Ttl/vna/README.md

Homemade 30 MHZ - 6 GHz single receiver VNA design files.
