Ttl/vna/(threads)

Thread 1 (2018-06-11):

Questions about the simu sw, and calibrations

shinong, 2018-06-11:
Hi,
First of all, thank you so much for sharing the design of your self-designed VNA. I did learn a lot from your docs. And it helped me a lot on my thesis research. However, I do have some questions about your documents in this project.
First, what is the simulation software you used in your design stage, and how you generated your PCB layout? Did you calculate the width of the trace and use this parameter for manual routing or you used the simu software to generate the layout directly?
Second, for the calibration method. You used the 3-term error model for 1 port cali, and you used magnitudes only for calibration. I am not clear about how phase data is used for calibration? Cause you mentioned in another project that VNA is more accurate than SNA because of the phase correction.
Those are all questions I have for now. Could you please take some time to look at them and reply me whenever you are convenient? Really appreciated!

Thanks,
Shinong

Ttl, 2018-06-12:
There isn't that much to simulate. Most is done just with pen and paper. Couplers were simulated using EM simulator. Line width was calculated to give 50 ohm impedance and the layout was done manually in KiCad.

Phases are needed because in general linear two ports have phases and we need to solve the coefficients of the error network during the calibration.

Closed 2018-06-12.

Thread 2 (2018-06-17):

LICENSE?

Immortalin, 2018-06-17:
Which license is this under?

Ttl, 2018-06-18:
Firmware is GPL (See firmware/COPYING for license). I guess I never put any license for software. Do you want it to have some specific license?

Immortalin, 2018-06-18:
I mean is the EE considered to be Open Hardware?

Ttl, 2018-06-18:
Sure. Do what you want with it. Hardware can't be copyrighted anyways.

UsedUp, 2019-06-29:
Has anybody compiled a BOM for the improved version of the vna?  I saw a mention of somebody in the process of doing it but I have seen no final list though I have noticed a list changes for the components which I cannot read (understand).  I can make a tiny amount of sense like maybe the kind of part but value and SMD size are beyond my grasp of the system.  Maybe all I need is to know which software reads the file  (is that all in Kicad, which I glanced at but have not tried downloading? ) (I have been using Target)?  To be honest, I have never tried building anything of this sort and recently have been doing circuits using maybe 50 parts and doing the bookkeeping myself.  Conversely. I have an immediate job where the VNA could greatly help.
    If just setting up Kicad is enough then I am ready to go that route even if it takes some learning of a different program.  I just read a comparison to Eagle and the author left me feeling they are comparable. Maybe I will actually be happier doing so. Target has some habits I could do without when placing components very near each other.
