Ttl/vna/hardware/vna_sch.pdf

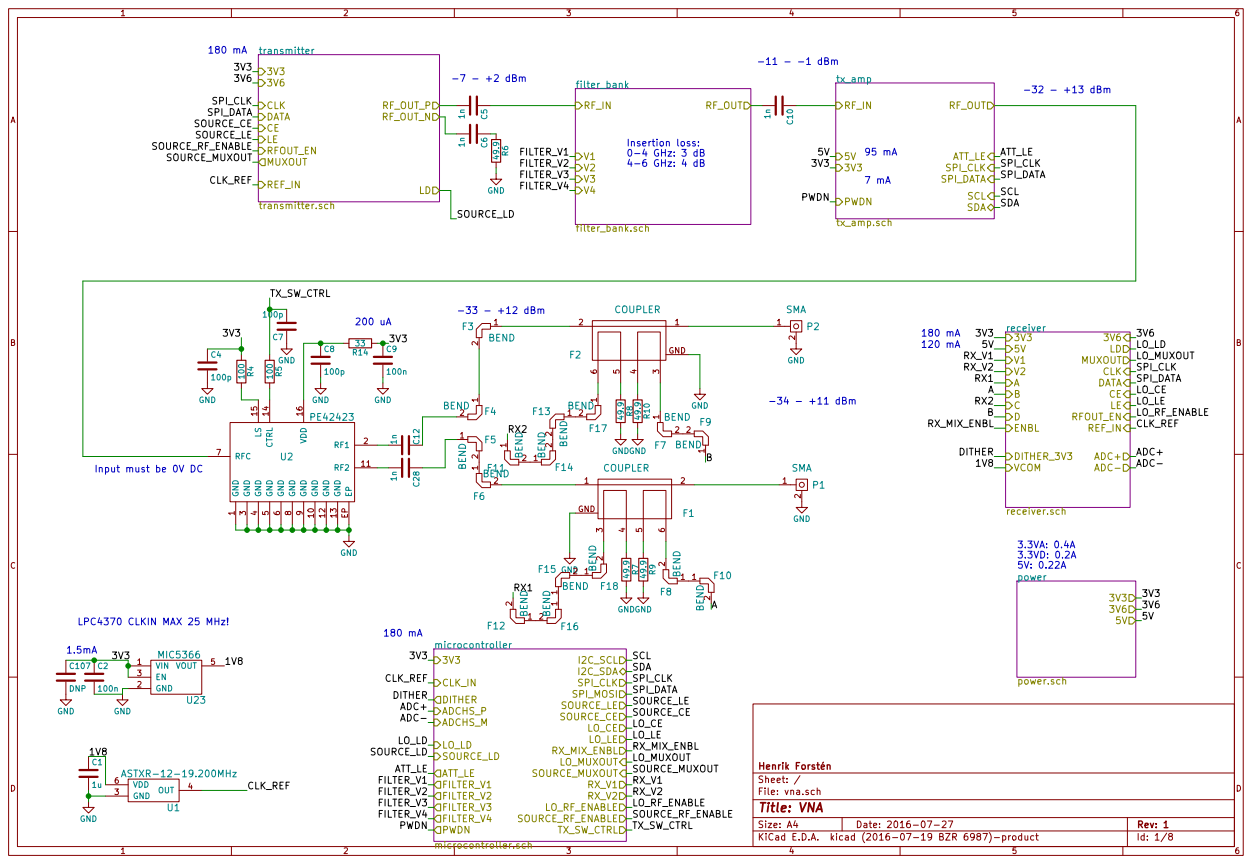
[picture p1: page 1]

Insertion loss: 0-4 GHz: 3 dB
4-6 GHz: 4 dB

9 GND 10 RF2 11 GND 12 GND 13 CTRL 14 LS 15 VDD 16 EP EP U2 PE42423

Input must be 0V DC

File: vna.sch Sheet: / Henrik Forstén

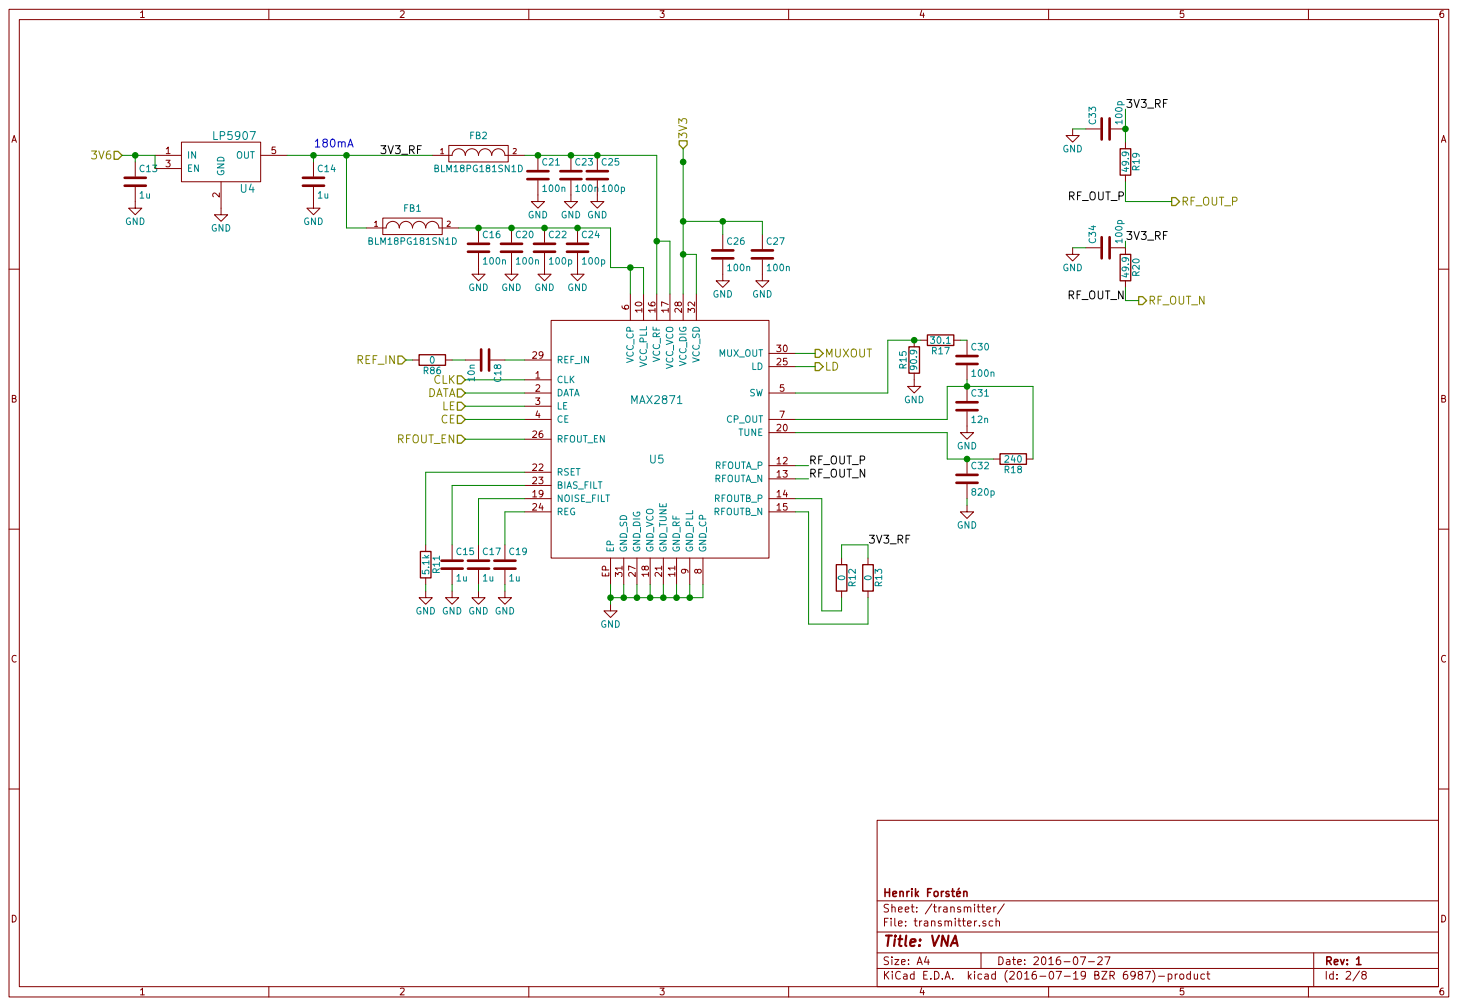
[picture p2: page 2]

100n GND GND GND GND GND

100n 5.1k R11 GND GND GND GND

File: transmitter.sch Sheet: /transmitter/ Henrik Forstén

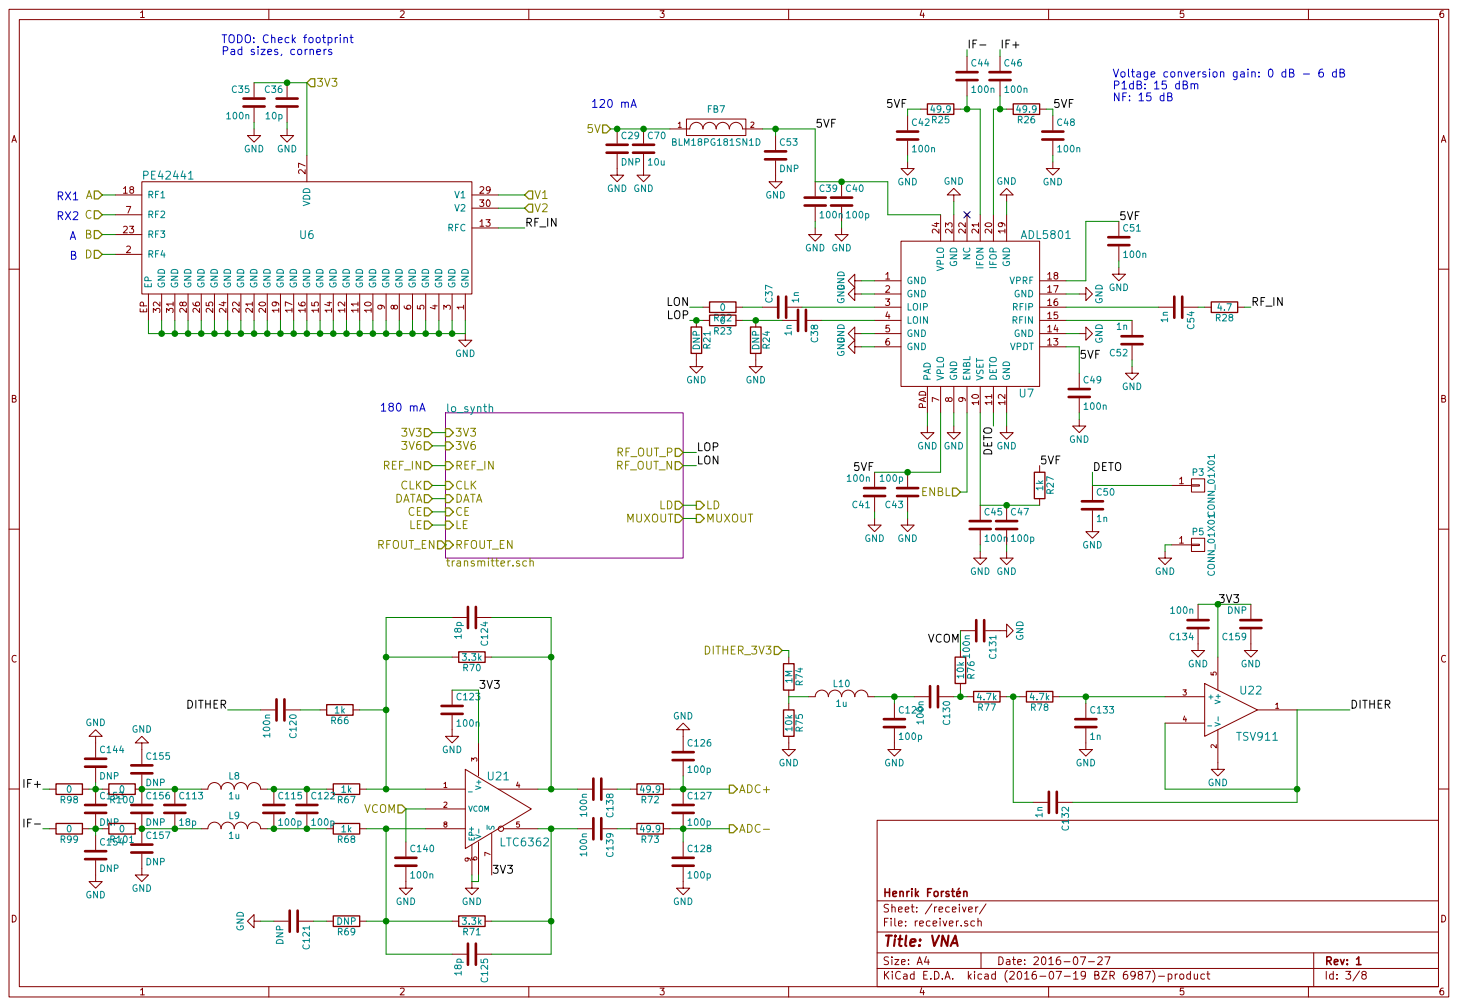
[picture p3: page 3]

9 GND 10 GND 20 V2 30 GND 11 GND 21 GND 31 GND 12 GND 22 GND 32 RFC 13 RF3 23 GND 14 GND 24 GND 15 GND 25 GND 16 GND 26 GND 17 VDD 27 RF1 18 GND 28 GND 19 V1 29 EP EP U6 PE42441

9 VSET 10 IFOP 20 DETO 11 IFON 21 GND 12 NC 22 VPDT 13 GND 23 GND 14 VPLO 24 RFIN 15 RFIP 16 GND 17 VPRF 18 GND 19 PAD PADU7ADL5801 RF_IN GND GND C37 1n

File: receiver.sch Sheet: /receiver/ Henrik Forstén GND

C155 DNP C157 DNP GND GND

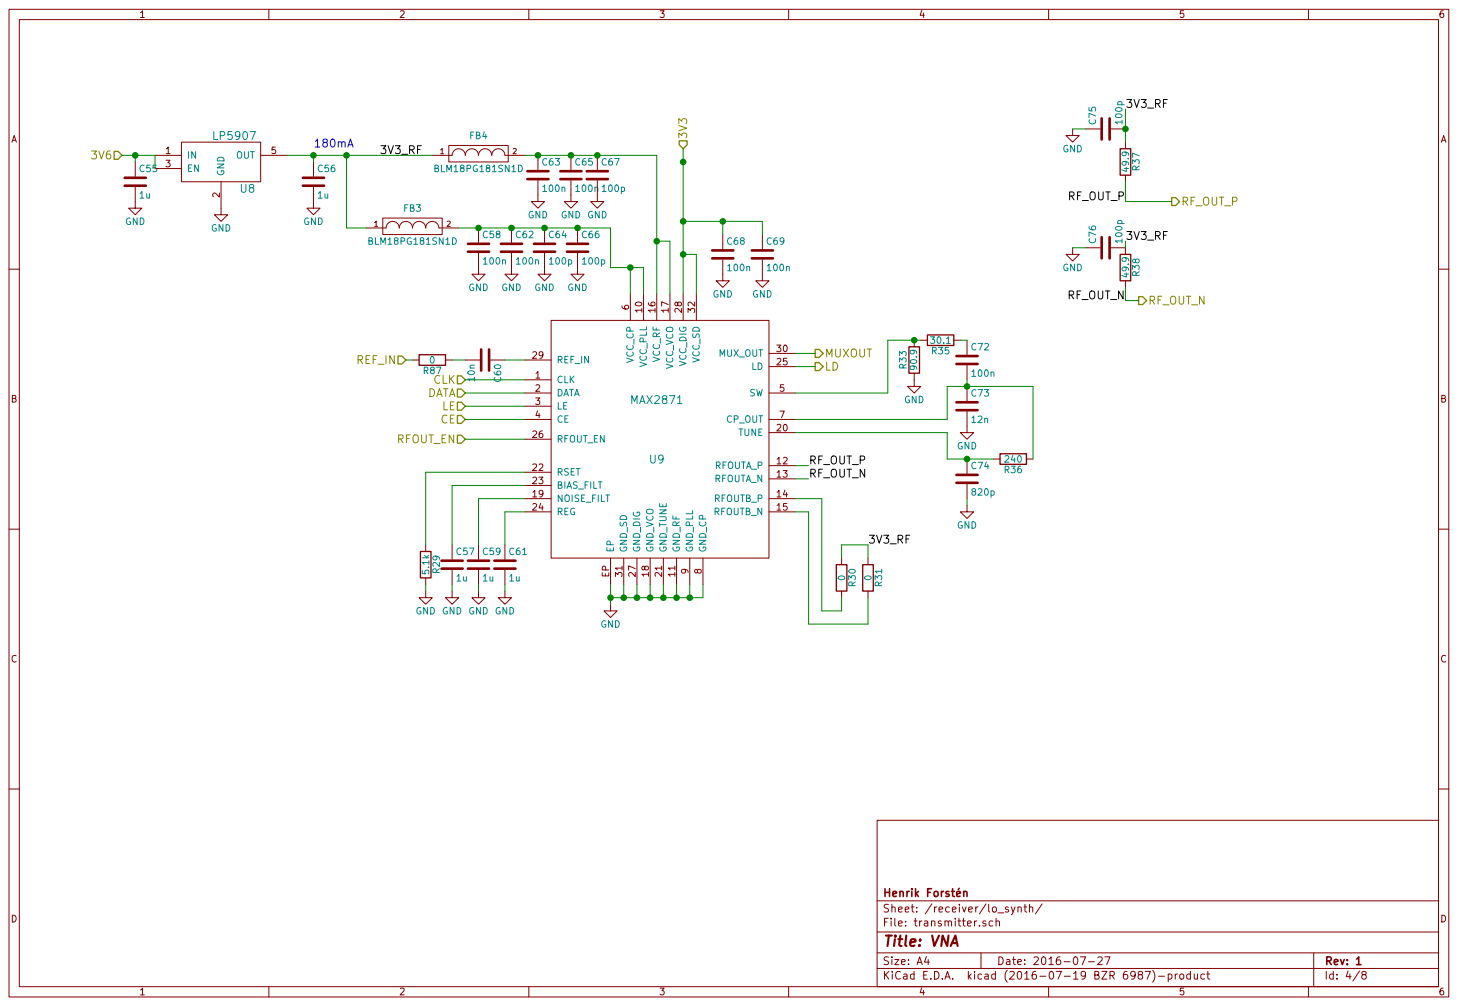
[picture p4: page 4]

100n GND GND GND GND GND

100n 5.1k R29 GND GND GND GND

Henrik Forstén
File: transmitter.sch Sheet: /receiver/lo_synth/
Id: 4/8 Title: VNA

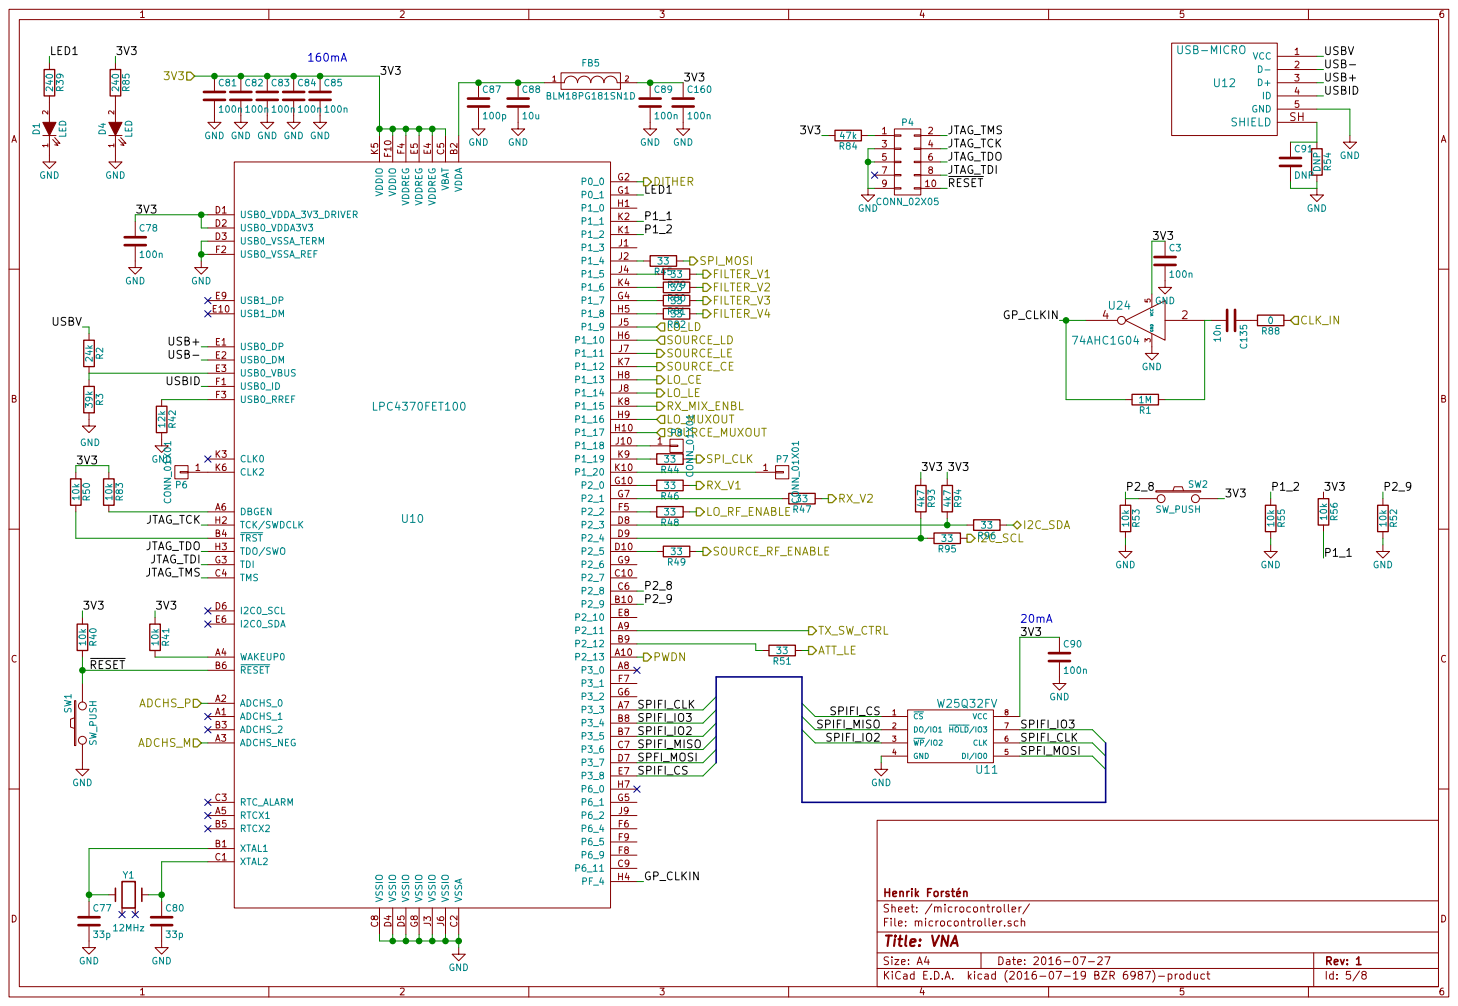
[picture p5: page 5]

LPC4370FET100 GND GND GND GND GND

SPIFI_IO2
SPIFI_MISO
SPFI_MOSI

File: microcontroller.sch Sheet: /microcontroller/ Henrik Forstén

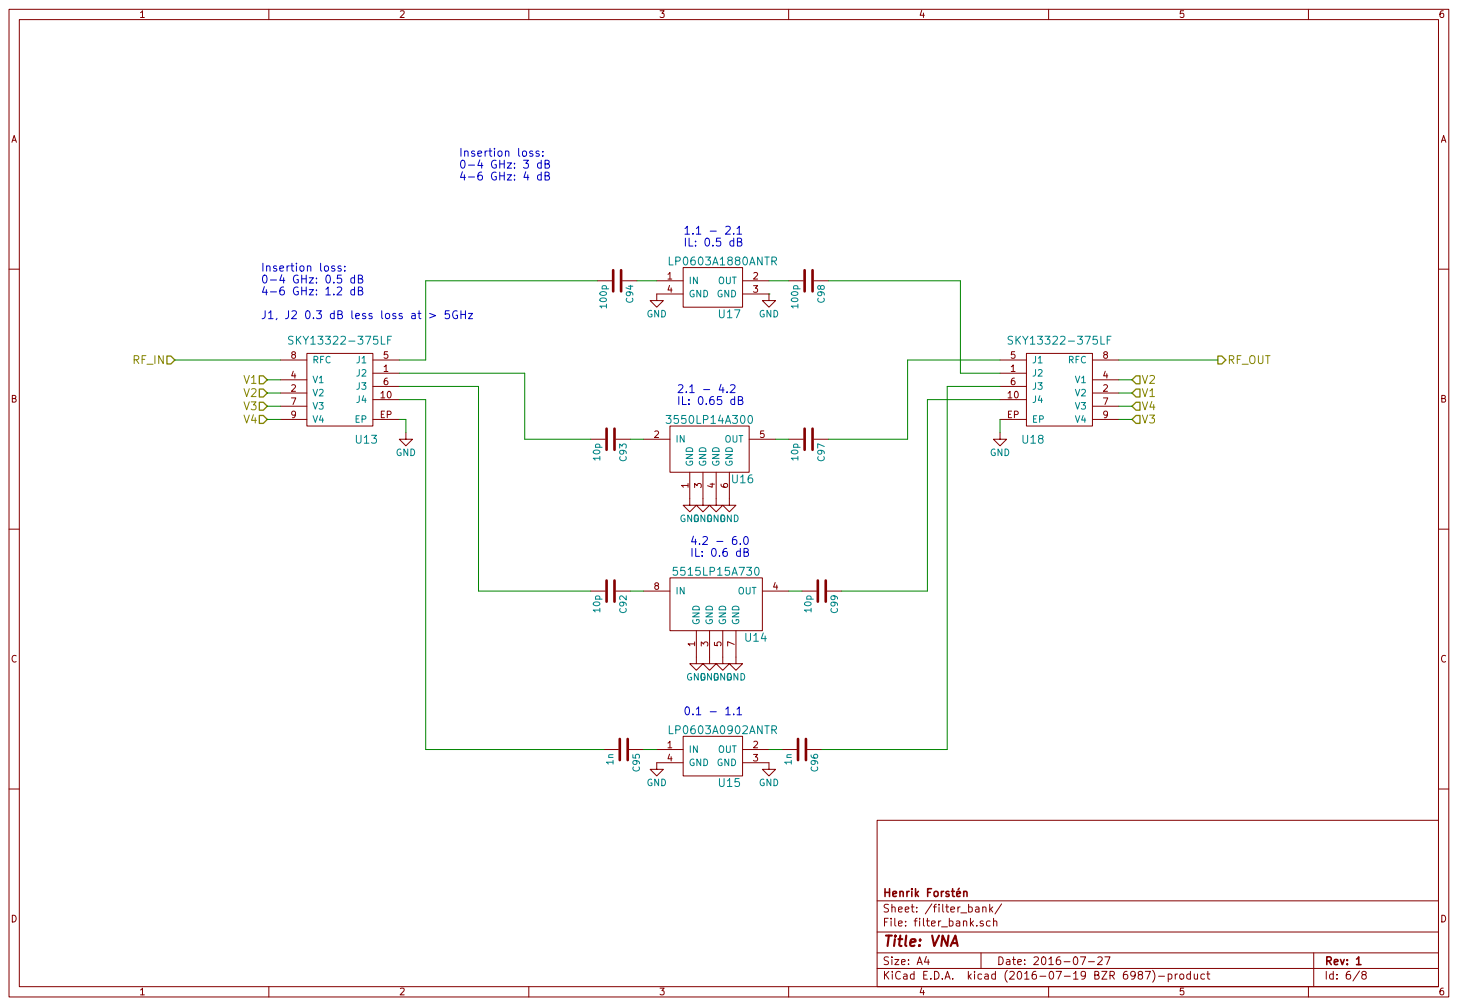
[picture p6: page 6]

Insertion loss: 0-4 GHz: 3 dB
4-6 GHz: 4 dB

Insertion loss: 0-4 GHz: 0.5 dB
4-6 GHz: 1.2 dB
J1, J2 0.3 dB less loss at > 5GHz

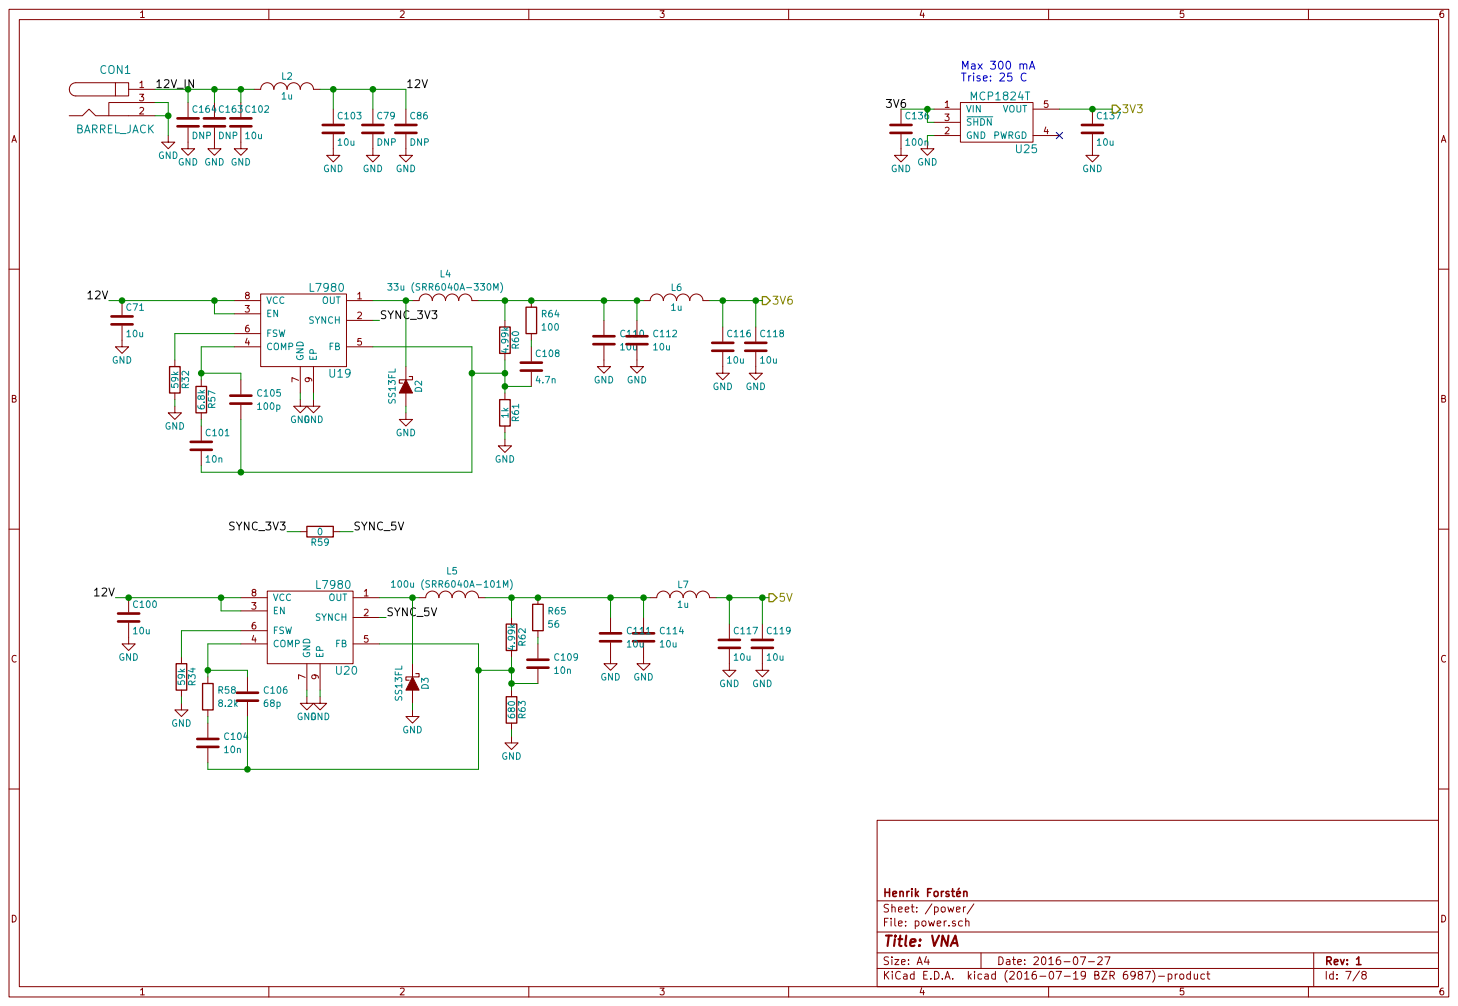
[picture p7: page 7]

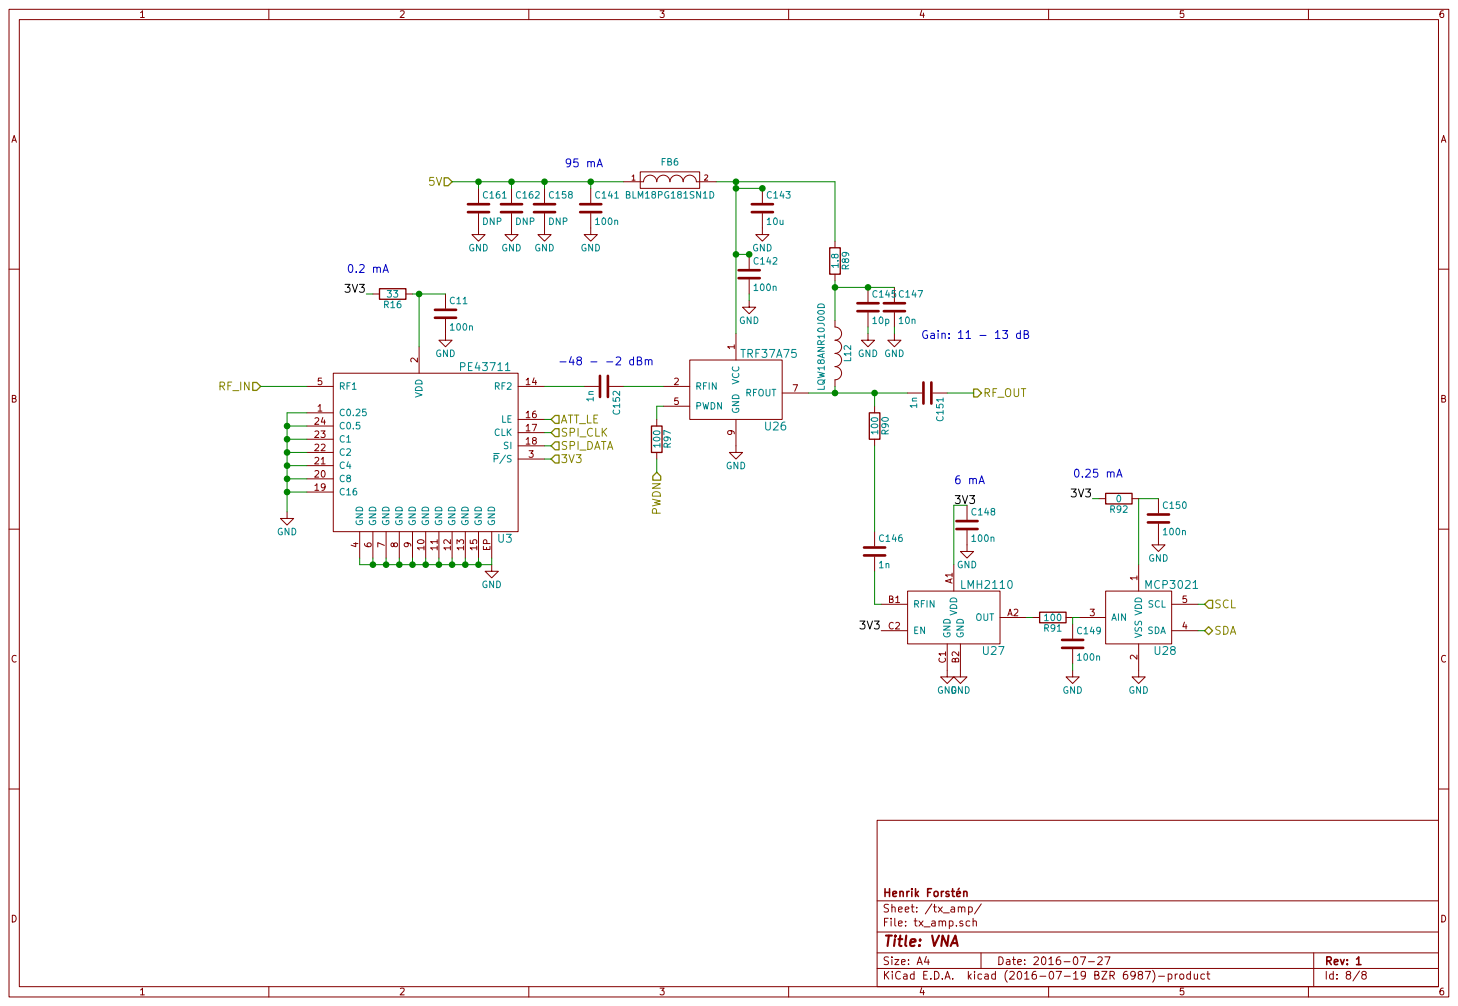
[picture p8: page 8]

1 RFIN 2 PWDN 5 RFOUT 7 GND

9 GND 10 C8 20 GND 11 C4 21 GND 12 C2 22 GND 13 C1 23 RF2 14 C0.5 24 GND 15
