Ttl/vna/hardware/vna.kicad_pcb

## KiCad design hardware/vna.kicad_pcb (2016-07-27)

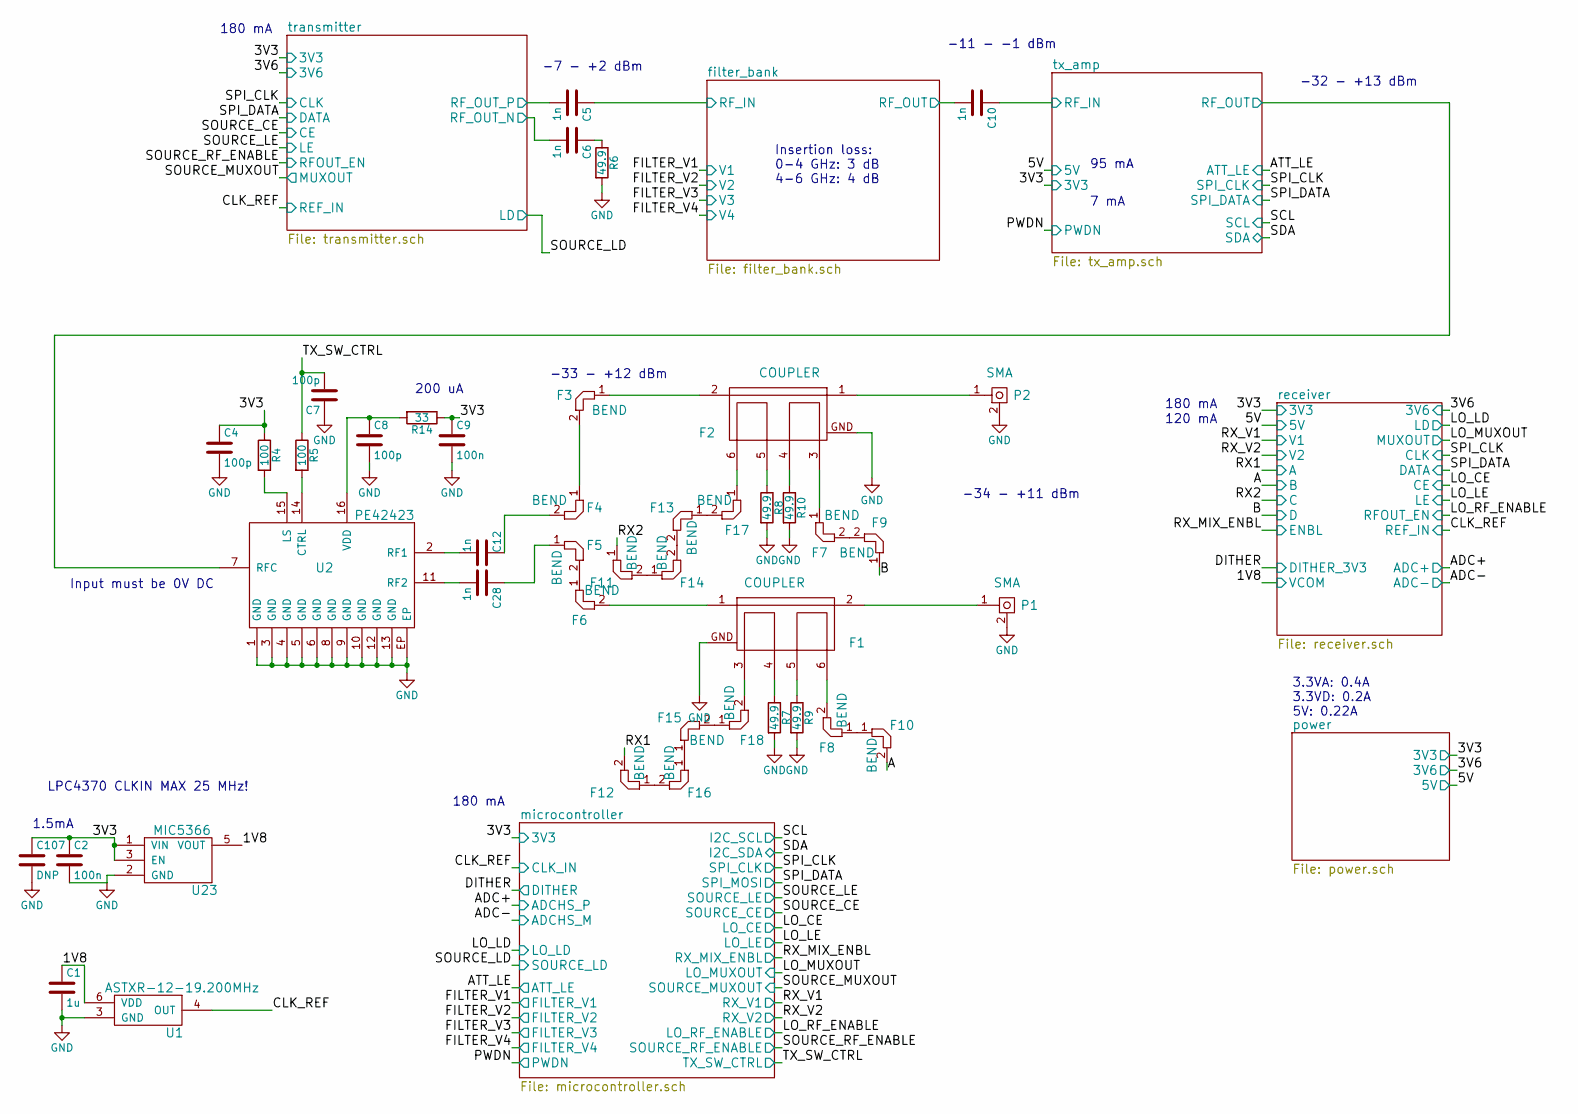
[picture p9: schematic vna.sch]

Parts:
C1: 1u; C_0402b
C2, C9: 100n; C_0402b
C4, C7, C8: 100p; C_0402b
C5, C6, C10, C12, C28: 1n; C_0402b
C107: DNP; C_0805b
F1, F2: COUPLER; coupler4
F3, F4, F5, F6, F7, F8, F9, F10, F11, F12, F13, F14, F15, F16, F17, F18: BEND; uwmiter_0.34_0.17_45
P1, P2: SMA; CONSMA003.062
R4, R5: 100; R_0402b
R6, R7, R8, R9, R10: 49.9; R_0402b
R14: 33; R_0402b
U1: ASTXR-12-19.200MHz; ASTRX-12
U2: PE42423; VQFN-16
U23: MIC5366; SOT-353

Connections:
/filter_bank/RF_IN: C5.1; also elsewhere on the board
/filter_bank/RF_OUT: C10.2; also elsewhere on the board
/microcontroller/3V3: C2.1, C4.1, C9.1, C107.1, R4.1, R14.1, U23.1 (VIN), U23.3 (EN); also elsewhere on the board
/microcontroller/CLK_IN: U1.4 (OUT); also elsewhere on the board
/microcontroller/TX_SW_CTRL: C7.2, R5.1; also elsewhere on the board
/receiver/A: F12.2; also elsewhere on the board
/receiver/B: F10.2; also elsewhere on the board
/receiver/C: F11.1; also elsewhere on the board
/receiver/D: F9.1; also elsewhere on the board
/receiver/VCOM: C1.1, U1.6 (VDD), U23.5 (VOUT); also elsewhere on the board
/transmitter/RF_OUT_N: C6.2; also elsewhere on the board
/transmitter/RF_OUT_P: C5.2; also elsewhere on the board
/tx_amp/RF_IN: C10.1; also elsewhere on the board
/tx_amp/RF_OUT: U2.7 (RFC); also elsewhere on the board
GND: C1.2, C2.2, C4.2, C7.1, C8.2, C9.2, C107.2, F1.GND, F2.GND, P1.2, P2.2, R6.2, R7.2, R8.2, R9.2, R10.2, U1.3 (GND), U2.1 (GND), U2.3 (GND), U2.4 (GND), U2.5 (GND), U2.6 (GND), U2.8 (GND), U2.9 (GND), U2.10 (GND), U2.12 (GND), U2.13 (GND), U2.EP, U23.2 (GND); also elsewhere on the board
unnamed: C6.1, R6.1
unnamed: C8.1, R14.2, U2.16 (VDD)
unnamed: C12.1, F4.2
unnamed: C12.2, U2.2 (RF1)
unnamed: C28.1, F5.1
unnamed: C28.2, U2.11 (RF2)
unnamed: F1.1, F6.2
unnamed: F1.2, P1.1
unnamed: F1.3, F18.2
unnamed: F1.4, R7.1
unnamed: F1.5, R9.1
unnamed: F1.6, F8.2
unnamed: F2.1, P2.1
unnamed: F2.2, F3.1
unnamed: F2.3, F7.1
unnamed: F2.4, R10.1
unnamed: F2.5, R8.1
unnamed: F3.2, F4.1
unnamed: F5.2, F6.1
unnamed: F7.2, F9.2
unnamed: F8.1, F10.1
unnamed: F11.2, F14.1
unnamed: F12.1, F16.2
unnamed: F13.1, F17.2
unnamed: F13.2, F14.2
unnamed: F15.1, F16.1
unnamed: F15.2, F18.1
unnamed: F2.6, F17.1
unnamed: R4.2, U2.15 (LS)
unnamed: R5.2, U2.14 (CTRL)

Notes on the sheet:
1.5mA
Input must be 0V DC
Insertion loss: 0-4 GHz: 3 dB 4-6 GHz: 4 dB
-7 - +2 dBm
-11 - -1 dBm
-32 - +13 dBm
-33 - +12 dBm
-34 - +11 dBm
200 uA
180 mA
120 mA
3.3VA: 0.4A 3.3VD: 0.2A 5V: 0.22A
LPC4370 CLKIN MAX 25 MHz!
95 mA
7 mA

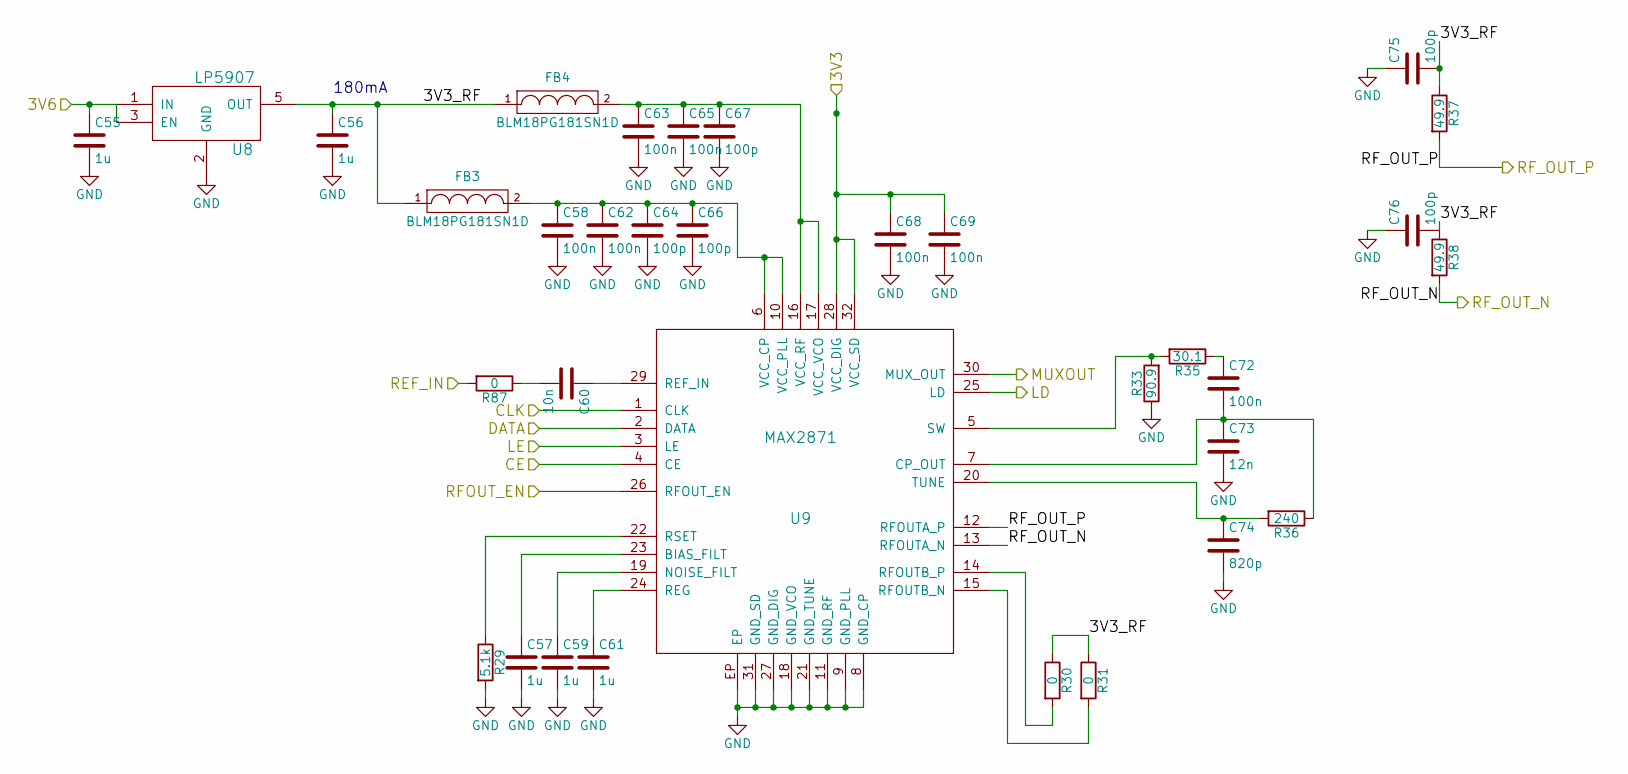
[picture p10: schematic transmitter.sch, VNA]

Parts:
C13, C14, C15, C17, C19: 1u; C_0603b
C16, C20, C21, C23, C26, C27, C30: 100n; C_0402b
C18: 10n; C_0402b
C22, C24, C25, C33, C34: 100p; C_0402b
C31: 12n; C_0402b
C32: 820p; C_0402b
FB1, FB2: BLM18PG181SN1D; C_0603b
R11: 5.1k; R_0402b
R12, R13, R86: 0; R_0402b
R15: 90.9; R_0402b
R17: 30.1; R_0402b
R18: 240; R_0402b
R19, R20: 49.9; R_0402b
U4: LP5907; SOT-23-5
U5: MAX2871; TQFN-32

Connections:
/microcontroller/3V3: C26.1, C27.1, U5.28 (VCC_DIG), U5.32 (VCC_SD); also elsewhere on the board
/microcontroller/CLK_IN: R86.2; also elsewhere on the board
/power/3V6: C13.1, U4.1 (IN), U4.3 (EN); also elsewhere on the board
/receiver/CLK: U5.1 (CLK); also elsewhere on the board
/receiver/DATA: U5.2 (DATA); also elsewhere on the board
/transmitter/3V3_RF: C14.1, C33.2, C34.2, FB1.1, FB2.1, R12.1, R13.1, R19.1, R20.1, U4.5 (OUT)
/transmitter/CE: U5.4 (CE); also elsewhere on the board
/transmitter/LD: U5.25 (LD); also elsewhere on the board
/transmitter/LE: U5.3 (LE); also elsewhere on the board
/transmitter/MUXOUT: U5.30 (MUX_OUT); also elsewhere on the board
/transmitter/RFOUT_EN: U5.26 (RFOUT_EN); also elsewhere on the board
/transmitter/RF_OUT_N: R20.2, U5.13 (RFOUTA_N); also elsewhere on the board
/transmitter/RF_OUT_P: R19.2, U5.12 (RFOUTA_P); also elsewhere on the board
GND: C13.2, C14.2, C15.2, C16.2, C17.2, C19.2, C20.2, C21.2, C22.2, C23.2, C24.2, C25.2, C26.2, C27.2, C31.2, C32.2, C33.1, C34.1, R11.2, R15.1, U4.2 (GND), U5.8 (GND_CP), U5.9 (GND_PLL), U5.11 (GND_RF), U5.18 (GND_VCO), U5.21 (GND_TUNE), U5.27 (GND_DIG), U5.31 (GND_SD), U5.EP; also elsewhere on the board
unnamed: C15.1, U5.23 (BIAS_FILT)
unnamed: C16.1, C20.1, C22.1, C24.1, FB1.2, U5.6 (VCC_CP), U5.10 (VCC_PLL)
unnamed: C17.1, U5.19 (NOISE_FILT)
unnamed: C18.1, U5.29 (REF_IN)
unnamed: C18.2, R86.1
unnamed: C19.1, U5.24 (REG)
unnamed: C21.1, C23.1, C25.1, FB2.2, U5.16 (VCC_RF), U5.17 (VCC_VCO)
unnamed: C30.1, R17.1
unnamed: C30.2, C31.1, R18.1, U5.7 (CP_OUT)
unnamed: C32.1, R18.2, U5.20 (TUNE)
unnamed: R11.1, U5.22 (RSET)
unnamed: R12.2, U5.14 (RFOUTB_P)
unnamed: R13.2, U5.15 (RFOUTB_N)
unnamed: R15.2, R17.2, U5.5 (SW)

Parts of its further copies:
C55, C56, C57, C59, C61: 1u; C_0603b
C58, C62, C63, C65, C68, C69, C72: 100n; C_0402b
C60: 10n; C_0402b
C64, C66, C67, C75, C76: 100p; C_0402b
C73: 12n; C_0402b
C74: 820p; C_0402b
FB3, FB4: BLM18PG181SN1D; C_0603b
R29: 5.1k; R_0402b
R30, R31, R87: 0; R_0402b
R33: 90.9; R_0402b
R35: 30.1; R_0402b
R36: 240; R_0402b
R37, R38: 49.9; R_0402b
U8: LP5907; SOT-23-5
U9: MAX2871; TQFN-32

Connections of its further copies:
/microcontroller/3V3: C68.1, C69.1, U9.28 (VCC_DIG), U9.32 (VCC_SD); also elsewhere on the board
/microcontroller/CLK_IN: R87.2; also elsewhere on the board
/microcontroller/LO_MUXOUT: U9.30 (MUX_OUT); also elsewhere on the board
/microcontroller/LO_RF_ENABLE: U9.26 (RFOUT_EN); also elsewhere on the board
/power/3V6: C55.1, U8.1 (IN), U8.3 (EN); also elsewhere on the board
/receiver/CE: U9.4 (CE); also elsewhere on the board
/receiver/CLK: U9.1 (CLK); also elsewhere on the board
/receiver/DATA: U9.2 (DATA); also elsewhere on the board
/receiver/LD: U9.25 (LD); also elsewhere on the board
/receiver/LE: U9.3 (LE); also elsewhere on the board
/receiver/lo_synth/3V3_RF: C56.1, C75.2, C76.2, FB3.1, FB4.1, R30.1, R31.1, R37.1, R38.1, U8.5 (OUT)
/receiver/lo_synth/RF_OUT_N: R38.2, U9.13 (RFOUTA_N); also elsewhere on the board
/receiver/lo_synth/RF_OUT_P: R37.2, U9.12 (RFOUTA_P); also elsewhere on the board
GND: C55.2, C56.2, C57.2, C58.2, C59.2, C61.2, C62.2, C63.2, C64.2, C65.2, C66.2, C67.2, C68.2, C69.2, C73.2, C74.2, C75.1, C76.1, R29.2, R33.1, U8.2 (GND), U9.8 (GND_CP), U9.9 (GND_PLL), U9.11 (GND_RF), U9.18 (GND_VCO), U9.21 (GND_TUNE), U9.27 (GND_DIG), U9.31 (GND_SD), U9.EP; also elsewhere on the board
unnamed: C57.1, U9.23 (BIAS_FILT)
unnamed: C58.1, C62.1, C64.1, C66.1, FB3.2, U9.6 (VCC_CP), U9.10 (VCC_PLL)
unnamed: C59.1, U9.19 (NOISE_FILT)
unnamed: C60.1, U9.29 (REF_IN)
unnamed: C60.2, R87.1
unnamed: C61.1, U9.24 (REG)
unnamed: C63.1, C65.1, C67.1, FB4.2, U9.16 (VCC_RF), U9.17 (VCC_VCO)
unnamed: C72.1, R35.1
unnamed: C72.2, C73.1, R36.1, U9.7 (CP_OUT)
unnamed: C74.1, R36.2, U9.20 (TUNE)
unnamed: R29.1, U9.22 (RSET)
unnamed: R30.2, U9.14 (RFOUTB_P)
unnamed: R31.2, U9.15 (RFOUTB_N)
unnamed: R33.2, R35.2, U9.5 (SW)

Notes on the sheet:
180mA

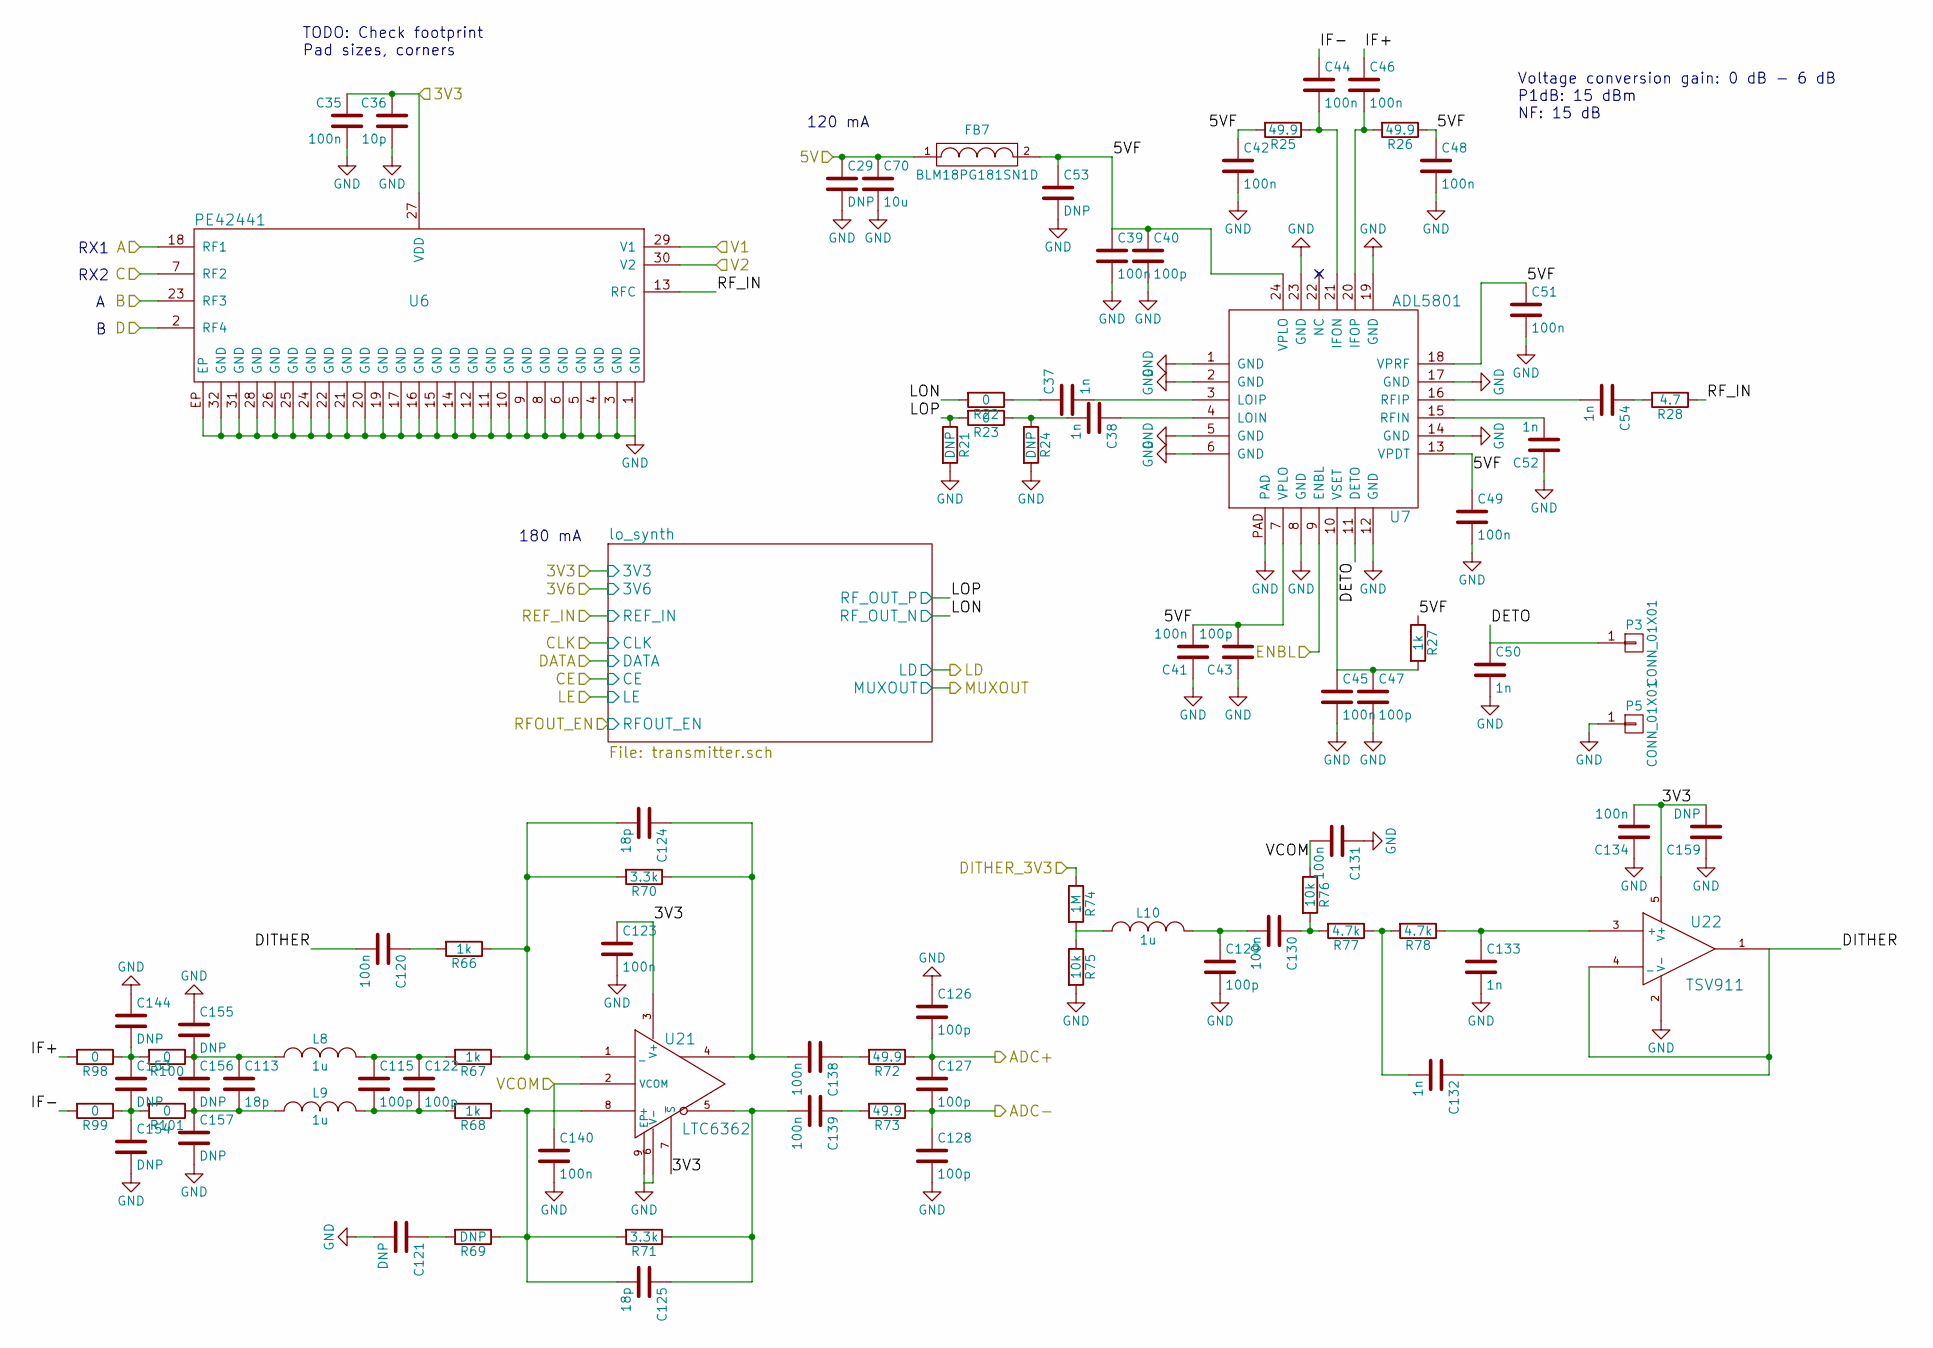
[picture p11: schematic receiver.sch, VNA]

Parts:
C29: DNP; C_0603b
C35, C39, C41, C42, C44, C45, C46, C48, C49, C51, C120, C123, C130, C131, C134, C138, C139, C140: 100n; C_0402b
C36: 10p; C_0402b
C37, C38, C50, C52, C54, C132, C133: 1n; C_0402b
C40, C43, C47, C115, C122, C126, C127, C128, C129: 100p; C_0402b
C53, C159: DNP; C_0805b
C70: 10u; C_0805b
C113, C124, C125: 18p; C_0402b
C121, C144, C153, C154, C155, C156, C157: DNP; C_0402b
FB7: BLM18PG181SN1D; C_0603b
L8, L9, L10: 1u; C_0603b
P3, P5: CONN_01X01; TP_1.00
R21, R24, R69: DNP; R_0402b
R22, R23, R98, R99, R100, R101: 0; R_0402b
R25, R26, R72, R73: 49.9; R_0402b
R27, R66, R67, R68: 1k; R_0402b
R28: 4.7; R_0402b
R70, R71: 3.3k; R_0402b
R74: 1M; R_0402b
R75, R76: 10k; R_0402b
R77, R78: 4.7k; R_0402b
U6: PE42441; VFQFN-32
U7: ADL5801; VFQFN-24
U21: LTC6362; DFN-8-1EP_3x3mm_Pitch0.5mm
U22: TSV911; SOT-23-5

Connections:
/microcontroller/3V3: C35.1, C36.1, C123.1, C134.2, C159.2, U6.27 (VDD), U21.3 (V+), U21.7 (~S), U22.5 (V+); also elsewhere on the board
/microcontroller/DITHER: R74.1; also elsewhere on the board
/microcontroller/RX_V1: U6.29 (V1); also elsewhere on the board
/microcontroller/RX_V2: U6.30 (V2); also elsewhere on the board
/power/5V: C29.1, C70.1, FB7.1; also elsewhere on the board
/receiver/5VF: C39.1, C40.1, C41.2, C42.1, C43.2, C48.1, C49.1, C51.1, C53.1, FB7.2, R25.2, R26.1, R27.1, U7.7 (VPLO), U7.13 (VPDT), U7.18 (VPRF), U7.24 (VPLO)
/receiver/A: U6.18 (RF1); also elsewhere on the board
/receiver/ADC+: C126.2, C127.1, R72.1; also elsewhere on the board
/receiver/ADC-: C127.2, C128.1, R73.1; also elsewhere on the board
/receiver/B: U6.23 (RF3); also elsewhere on the board
/receiver/C: U6.7 (RF2); also elsewhere on the board
/receiver/D: U6.2 (RF4); also elsewhere on the board
/receiver/DETO: C50.1, P3.1, U7.11 (DETO)
/receiver/DITHER: C120.2, C132.1, U22.1, U22.4 (_)
/receiver/ENBL: U7.9 (ENBL); also elsewhere on the board
/receiver/IF+: C46.1, R98.2
/receiver/IF-: C44.1, R99.2
/receiver/RF_IN: R28.1, U6.13 (RFC)
/receiver/VCOM: C131.2, C140.1, R76.1, U21.2 (VCOM); also elsewhere on the board
/receiver/lo_synth/RF_OUT_N: R22.2; also elsewhere on the board
/receiver/lo_synth/RF_OUT_P: R21.1, R23.2; also elsewhere on the board
GND: C29.2, C35.2, C36.2, C39.2, C40.2, C41.1, C42.2, C43.1, C45.2, C47.2, C48.2, C49.2, C50.2, C51.2, C52.1, C53.2, C70.2, C121.2, C123.2, C126.1, C128.2, C129.2, C131.1, C133.2, C134.1, C140.2, C144.1, C154.2, C155.1, C157.2, C159.1, P5.1, R21.2, R24.2, R75.2, U6.1 (GND), U6.3 (GND), U6.4 (GND), U6.5 (GND), U6.6 (GND), U6.8 (GND), U6.9 (GND), U6.10 (GND), U6.11 (GND), U6.12 (GND), U6.14 (GND), U6.15 (GND), U6.16 (GND), U6.17 (GND), U6.19 (GND), U6.20 (GND), U6.21 (GND), U6.22 (GND), U6.24 (GND), U6.25 (GND), U6.26 (GND), U6.28 (GND), U6.31 (GND), U6.32 (GND), U6.EP, U7.1 (GND), U7.2 (GND), U7.5 (GND), U7.6 (GND), U7.8 (GND), U7.12 (GND), U7.14 (GND), U7.17 (GND), U7.19 (GND), U7.23 (GND), U7.PAD, U21.6 (V-), U21.9 (EP), U22.2 (V-); also elsewhere on the board
unnamed: C37.1, R22.1
unnamed: C37.2, U7.3 (LOIP)
unnamed: C38.1, U7.4 (LOIN)
unnamed: C38.2, R23.1, R24.1
unnamed: C44.2, R25.1, U7.21 (IFON)
unnamed: C45.1, C47.1, R27.2, U7.10 (VSET)
unnamed: C46.2, R26.2, U7.20 (IFOP)
unnamed: C52.2, U7.15 (RFIN)
unnamed: C54.1, R28.2
unnamed: C54.2, U7.16 (RFIP)
unnamed: C113.1, C155.2, C156.1, L8.1, R100.1
unnamed: C113.2, C156.2, C157.1, L9.1, R101.1
unnamed: C115.1, C122.1, L8.2, R67.2
unnamed: C115.2, C122.2, L9.2, R68.2
unnamed: C120.1, R66.2
unnamed: C121.1, R69.2
unnamed: C124.1, C138.2, R70.1, U21.4
unnamed: C124.2, R66.1, R67.1, R70.2, U21.1 (_)
unnamed: C125.1, C139.2, R71.1, U21.5
unnamed: C125.2, R68.1, R69.1, R71.2, U21.8 (+)
unnamed: C129.1, C130.2, L10.2
unnamed: C130.1, R76.2, R77.2
unnamed: C132.2, R77.1, R78.2
unnamed: C133.1, R78.1, U22.3 (+)
unnamed: C138.1, R72.2
unnamed: C139.1, R73.2
unnamed: C144.2, C153.1, R98.1, R100.2
unnamed: C153.2, C154.1, R99.1, R101.2
unnamed: L10.1, R74.2, R75.1

Notes on the sheet:
TODO: Check footprint Pad sizes, corners
Voltage conversion gain: 0 dB - 6 dB P1dB: 15 dBm NF: 15 dB
120 mA
180 mA
RX1
RX2

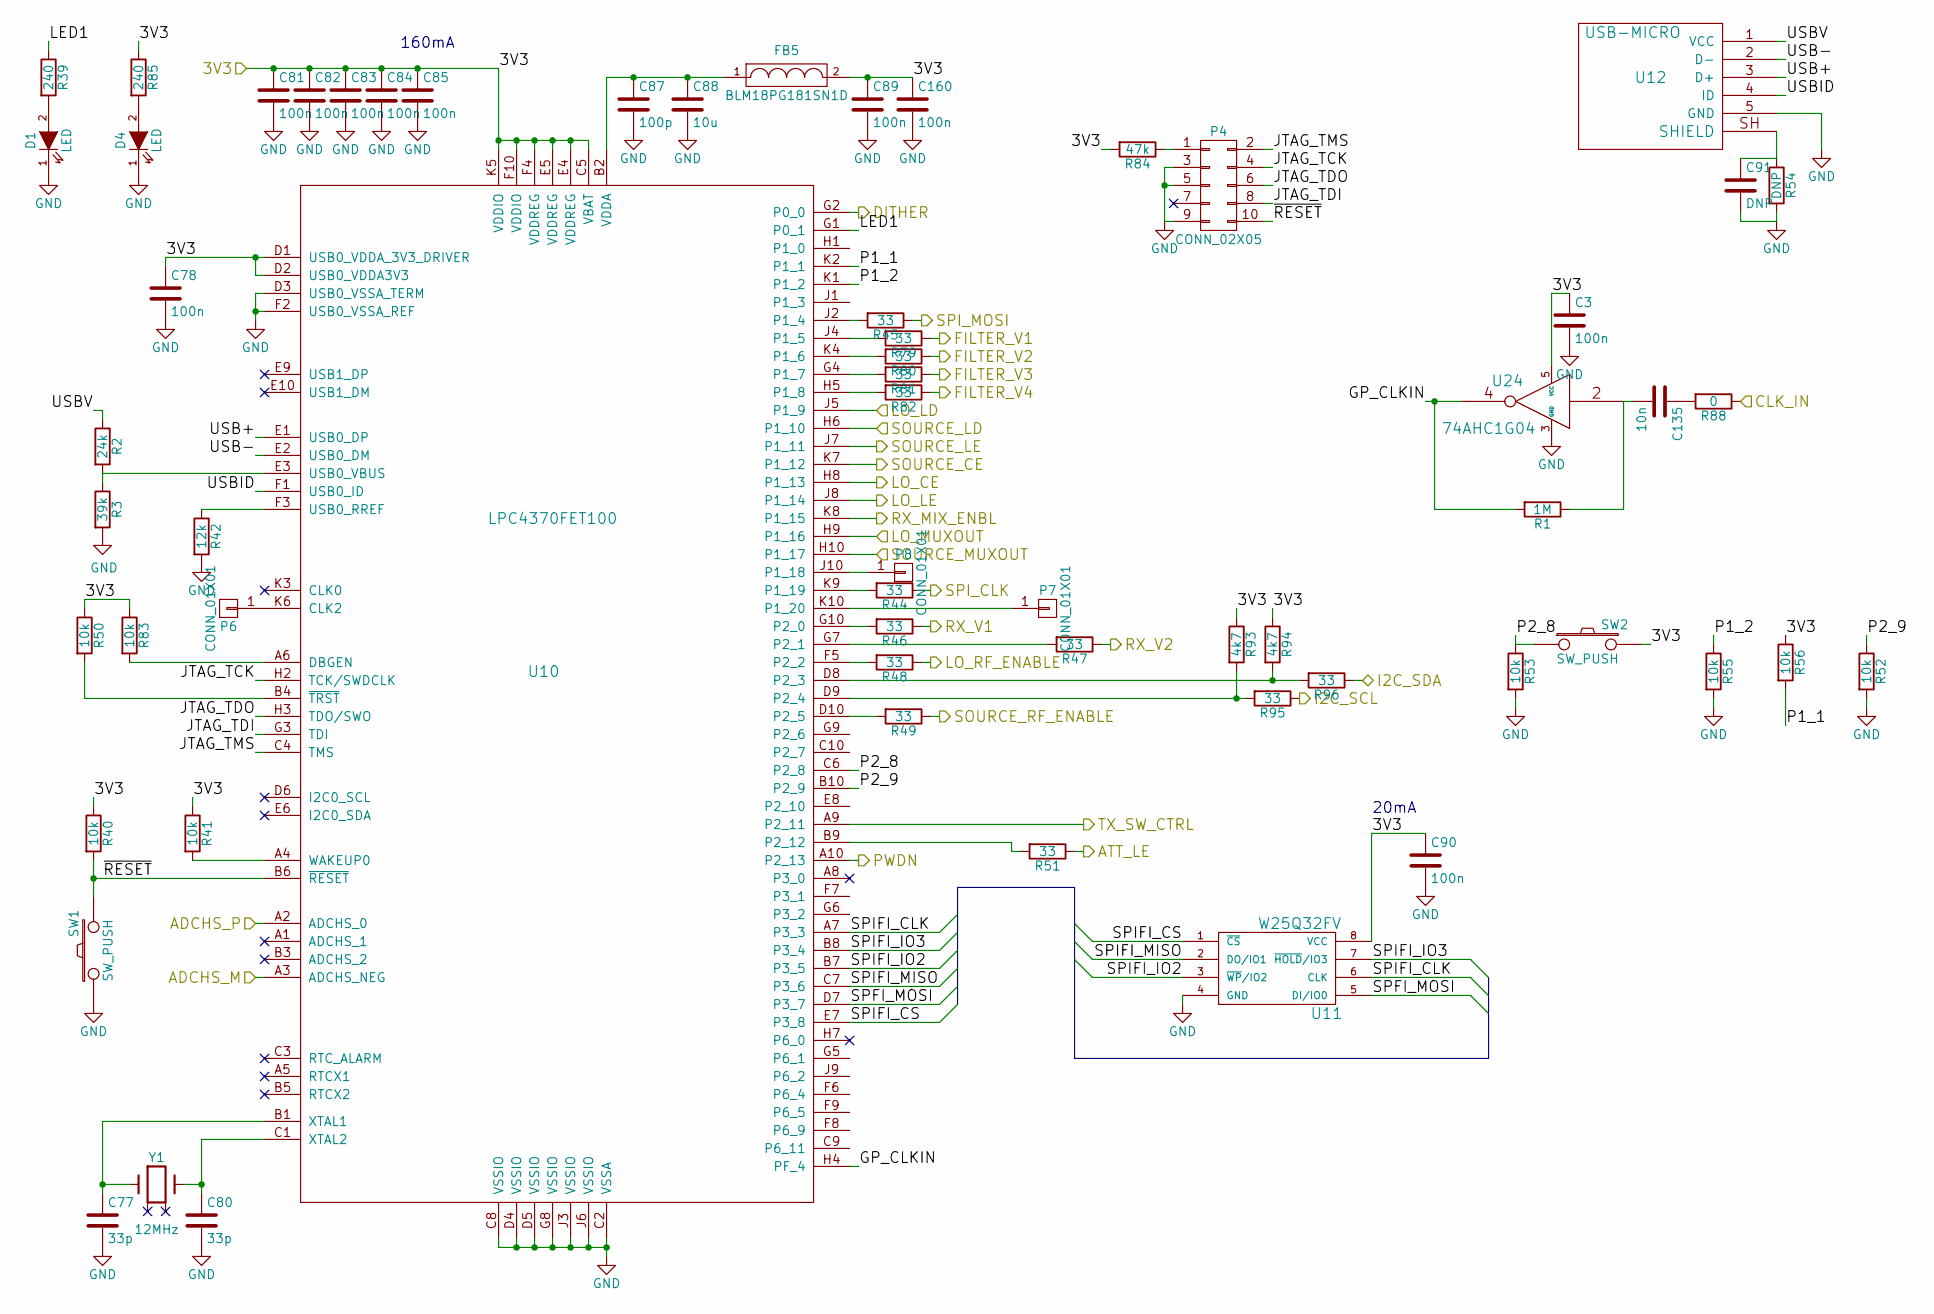
[picture p12: schematic microcontroller.sch, VNA]

Parts:
C3, C78, C81, C82, C83, C84, C85, C89, C90, C160: 100n; C_0402b
C77, C80: 33p; C_0402b
C87: 100p; C_0402b
C88: 10u; C_0805b
C91: DNP; C_0402b
C135: 10n; C_0402b
D1, D4: LED; LED_0603
FB5: BLM18PG181SN1D; C_0603b
P4: CONN_02X05; CNC-3220-10-0300-00
P6, P7, P8: CONN_01X01; TP_1.00
R1: 1M; R_0402b
R2: 24k; R_0402b
R3: 39k; R_0402b
R39, R85: 240; R_0402b
R40, R41, R50, R52, R53, R55, R56, R83: 10k; R_0402b
R42: 12k; R_0402b
R44, R45, R46, R47, R48, R49, R51, R79, R80, R81, R82, R95, R96: 33; R_0402b
R54: DNP; R_0402b
R84: 47k; R_0402b
R88: 0; R_0402b
R93, R94: 4k7; R_0402b
SW1, SW2: SW_PUSH; EVP-AWBA2A
U10: LPC4370FET100; TFBGA-100
U11: W25Q32FV; SOIJ-8_5.3x5.3mm_Pitch1.27mm
U12: USB-MICRO; USB_MICRO
U24: 74AHC1G04; SOT-353
Y1: 12MHz; XTAL_3.2x2.5

Connections:
/microcontroller/3V3: C3.1, C78.1, C81.1, C82.1, C83.1, C84.1, C85.1, C89.1, C90.1, C160.1, FB5.2, R40.1, R41.1, R50.1, R56.1, R83.1, R84.2, R85.1, R93.1, R94.1, SW2.2, U10.C5 (VBAT), U10.D1 (USB0_VDDA_3V3_DRIVER), U10.D2 (USB0_VDDA3V3), U10.E4 (VDDREG), U10.E5 (VDDREG), U10.F4 (VDDREG), U10.F10 (VDDIO), U10.K5 (VDDIO), U11.8 (VCC), U24.5 (VCC); also elsewhere on the board
/microcontroller/ATT_LE: R51.1; also elsewhere on the board
/microcontroller/CLK_IN: R88.1; also elsewhere on the board
/microcontroller/DITHER: U10.G2 (P0_0); also elsewhere on the board
/microcontroller/FILTER_V1: R79.1; also elsewhere on the board
/microcontroller/FILTER_V2: R80.1; also elsewhere on the board
/microcontroller/FILTER_V3: R81.1; also elsewhere on the board
/microcontroller/FILTER_V4: R82.1; also elsewhere on the board
/microcontroller/GP_CLKIN: R1.2, U10.H4 (PF_4), U24.4
/microcontroller/I2C_SCL: R95.1; also elsewhere on the board
/microcontroller/I2C_SDA: R96.1; also elsewhere on the board
/microcontroller/JTAG_TCK: P4.4, U10.H2 (TCK/SWDCLK)
/microcontroller/JTAG_TDI: P4.8, U10.G3 (TDI)
/microcontroller/JTAG_TDO: P4.6, U10.H3 (TDO/SWO)
/microcontroller/JTAG_TMS: P4.2, U10.C4 (TMS)
/microcontroller/LED1: R39.1, U10.G1 (P0_1)
/microcontroller/LO_MUXOUT: U10.H9 (P1_16); also elsewhere on the board
/microcontroller/LO_RF_ENABLE: R48.1; also elsewhere on the board
/microcontroller/P1_1: R56.2, U10.K2 (P1_1)
/microcontroller/P1_2: R55.1, U10.K1 (P1_2)
/microcontroller/P2_8: R53.1, SW2.1, U10.C6 (P2_8)
/microcontroller/P2_9: R52.1, U10.B10 (P2_9)
/microcontroller/PWDN: U10.A10 (P2_13); also elsewhere on the board
/microcontroller/RX_V1: R46.1; also elsewhere on the board
/microcontroller/RX_V2: R47.1; also elsewhere on the board
/microcontroller/SPFI_MOSI: U10.D7 (P3_7), U11.5 (DI/IO0)
/microcontroller/SPIFI_CLK: U10.A7 (P3_3), U11.6 (CLK)
/microcontroller/SPIFI_CS: U10.E7 (P3_8), U11.1 (~CS)
/microcontroller/SPIFI_IO2: U10.B7 (P3_5), U11.3 (~WP~/IO2)
/microcontroller/SPIFI_IO3: U10.B8 (P3_4), U11.7 (~HOLD~/IO3)
/microcontroller/SPIFI_MISO: U10.C7 (P3_6), U11.2 (DO/IO1)
/microcontroller/TX_SW_CTRL: U10.A9 (P2_11); also elsewhere on the board
/microcontroller/USB+: U10.E1 (USB0_DP), U12.3 (D+)
/microcontroller/USB-: U10.E2 (USB0_DM), U12.2 (D-)
/microcontroller/USBID: U10.F1 (USB0_ID), U12.4 (ID)
/microcontroller/USBV: R2.1, U12.1 (VCC)
/microcontroller/~RESET: P4.10, R40.2, SW1.2, U10.B6 (~RESET)
/receiver/ADC+: U10.A2 (ADCHS_0); also elsewhere on the board
/receiver/ADC-: U10.A3 (ADCHS_NEG); also elsewhere on the board
/receiver/CE: U10.H8 (P1_13); also elsewhere on the board
/receiver/CLK: R44.1; also elsewhere on the board
/receiver/DATA: R45.1; also elsewhere on the board
/receiver/ENBL: U10.K8 (P1_15); also elsewhere on the board
/receiver/LD: U10.J5 (P1_9); also elsewhere on the board
/receiver/LE: U10.J8 (P1_14); also elsewhere on the board
/transmitter/CE: U10.K7 (P1_12); also elsewhere on the board
/transmitter/LD: U10.H6 (P1_10); also elsewhere on the board
/transmitter/LE: U10.J7 (P1_11); also elsewhere on the board
/transmitter/MUXOUT: U10.H10 (P1_17); also elsewhere on the board
/transmitter/RFOUT_EN: R49.1; also elsewhere on the board
GND: C3.2, C77.2, C78.2, C80.2, C81.2, C82.2, C83.2, C84.2, C85.2, C87.2, C88.2, C89.2, C90.2, C91.2, C160.2, D1.1 (K), D4.1 (K), P4.3, P4.5, P4.9, R3.2, R42.2, R52.2, R53.2, R54.2, R55.2, SW1.1, U10.C2 (VSSA), U10.C8 (VSSIO), U10.D3 (USB0_VSSA_TERM), U10.D4 (VSSIO), U10.D5 (VSSIO), U10.F2 (USB0_VSSA_REF), U10.G8 (VSSIO), U10.J3 (VSSIO), U10.J6 (VSSIO), U11.4 (GND), U12.5 (GND), U24.3 (GND); also elsewhere on the board
unnamed: C77.1, U10.B1 (XTAL1), Y1.1
unnamed: C80.1, U10.C1 (XTAL2), Y1.3
unnamed: C87.1, C88.1, FB5.1, U10.B2 (VDDA)
unnamed: C91.1, R54.1, U12.SH (SHIELD)
unnamed: C135.1, R88.2
unnamed: C135.2, R1.1, U24.2
unnamed: D1.2 (A), R39.2
unnamed: D4.2 (A), R85.2
unnamed: P4.1, R84.1
unnamed: P6.1, U10.K6 (CLK2)
unnamed: P7.1, U10.K10 (P1_20)
unnamed: P8.1, U10.J10 (P1_18)
unnamed: R2.2, R3.1, U10.E3 (USB0_VBUS)
unnamed: R41.2, U10.A4 (WAKEUP0)
unnamed: R42.1, U10.F3 (USB0_RREF)
unnamed: R44.2, U10.K9 (P1_19)
unnamed: R45.2, U10.J2 (P1_4)
unnamed: R46.2, U10.G10 (P2_0)
unnamed: R47.2, U10.G7 (P2_1)
unnamed: R48.2, U10.F5 (P2_2)
unnamed: R49.2, U10.D10 (P2_5)
unnamed: R50.2, U10.B4 (~TRST)
unnamed: R51.2, U10.B9 (P2_12)
unnamed: R79.2, U10.J4 (P1_5)
unnamed: R80.2, U10.K4 (P1_6)
unnamed: R81.2, U10.G4 (P1_7)
unnamed: R82.2, U10.H5 (P1_8)
unnamed: R83.2, U10.A6 (DBGEN)
unnamed: R93.2, R95.2, U10.D9 (P2_4)
unnamed: R94.2, R96.2, U10.D8 (P2_3)

Notes on the sheet:
160mA
20mA

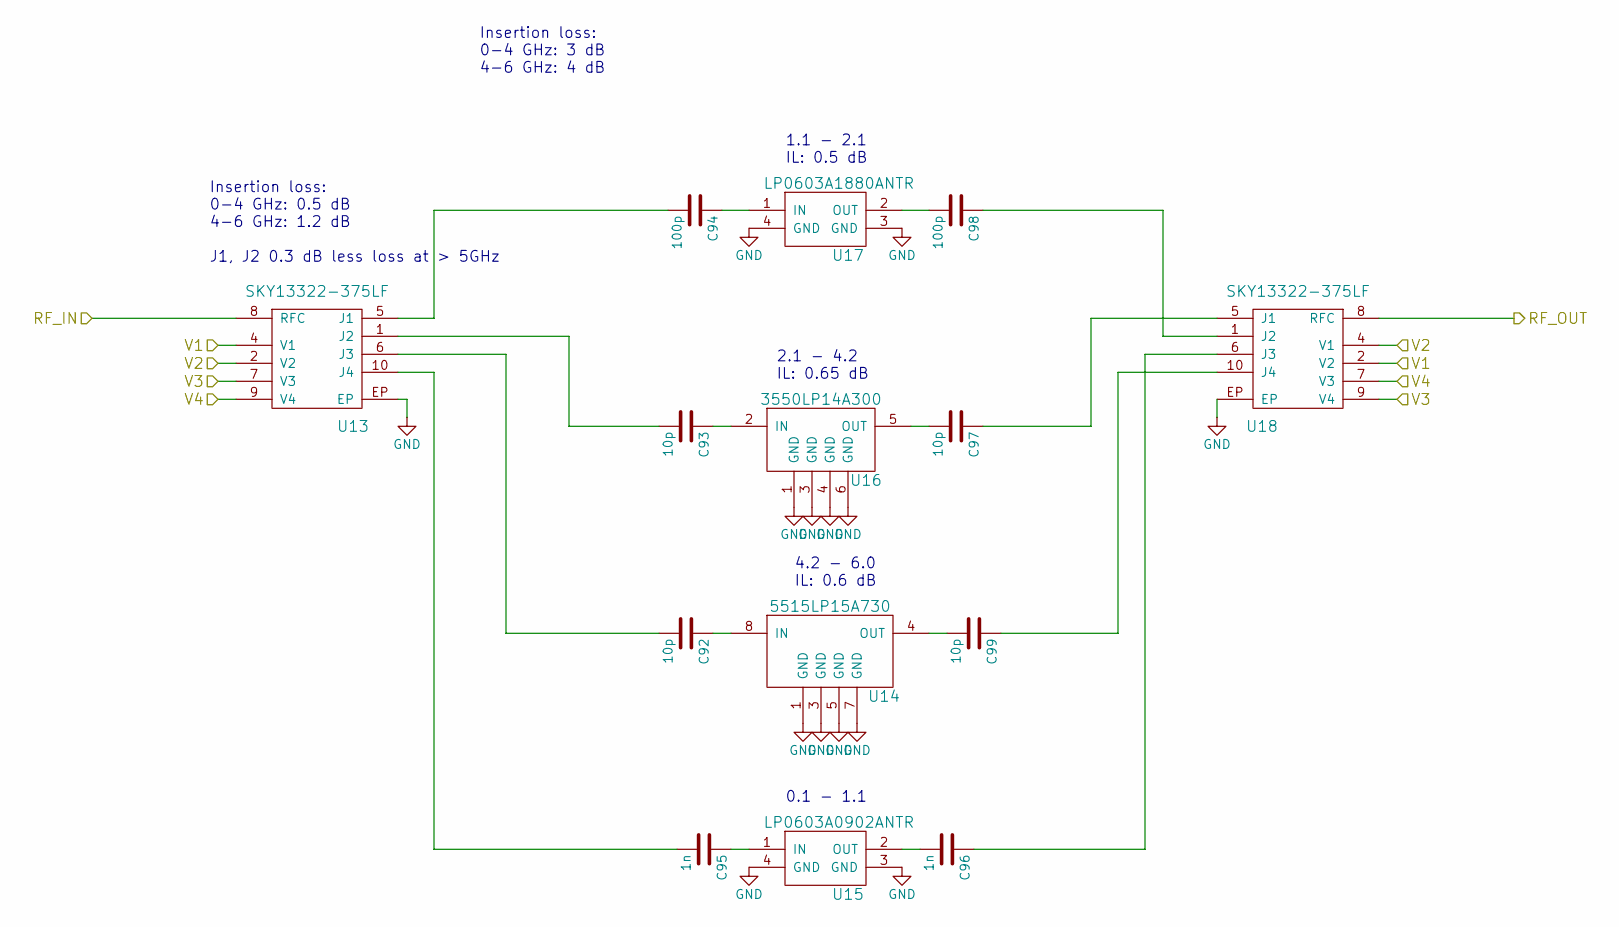
[picture p13: schematic filter_bank.sch, VNA]

Parts:
C92, C93, C97, C99: 10p; C_0402b
C94, C98: 100p; C_0402b
C95, C96: 1n; C_0402b
U13, U18: SKY13322-375LF; MLPD-10
U14: 5515LP15A730
U15: LP0603A0902ANTR; LP0603A0902
U16: 3550LP14A300
U17: LP0603A1880ANTR; LP0603A0902

Connections:
/filter_bank/RF_IN: U13.8 (RFC); also elsewhere on the board
/filter_bank/RF_OUT: U18.8 (RFC); also elsewhere on the board
/microcontroller/FILTER_V1: U13.4 (V1), U18.2 (V2); also elsewhere on the board
/microcontroller/FILTER_V2: U13.2 (V2), U18.4 (V1); also elsewhere on the board
/microcontroller/FILTER_V3: U13.7 (V3), U18.9 (V4); also elsewhere on the board
/microcontroller/FILTER_V4: U13.9 (V4), U18.7 (V3); also elsewhere on the board
GND: U13.EP, U14.1 (GND), U14.3 (GND), U14.5 (GND), U14.7 (GND), U15.3 (GND), U15.4 (GND), U16.1 (GND), U16.3 (GND), U16.4 (GND), U16.6 (GND), U17.3 (GND), U17.4 (GND), U18.EP; also elsewhere on the board
unnamed: C92.1, U14.8 (IN)
unnamed: C92.2, U13.6 (J3)
unnamed: C93.1, U16.2 (IN)
unnamed: C93.2, U13.1 (J2)
unnamed: C94.1, U17.1 (IN)
unnamed: C94.2, U13.5 (J1)
unnamed: C95.1, U15.1 (IN)
unnamed: C95.2, U13.10 (J4)
unnamed: C96.1, U18.6 (J3)
unnamed: C96.2, U15.2 (OUT)
unnamed: C97.1, U18.5 (J1)
unnamed: C97.2, U16.5 (OUT)
unnamed: C98.1, U18.1 (J2)
unnamed: C98.2, U17.2 (OUT)
unnamed: C99.1, U18.10 (J4)
unnamed: C99.2, U14.4 (OUT)

Notes on the sheet:
Insertion loss: 0-4 GHz: 0.5 dB 4-6 GHz: 1.2 dB J1, J2 0.3 dB less loss at > 5GHz
Insertion loss: 0-4 GHz: 3 dB 4-6 GHz: 4 dB
4.2 - 6.0 IL: 0.6 dB
2.1 - 4.2 IL: 0.65 dB
1.1 - 2.1 IL: 0.5 dB
0.1 - 1.1
