Ttl/vna/hardware/vna.kicad_pcb

## KiCad design hardware/vna.kicad_pcb (continued)

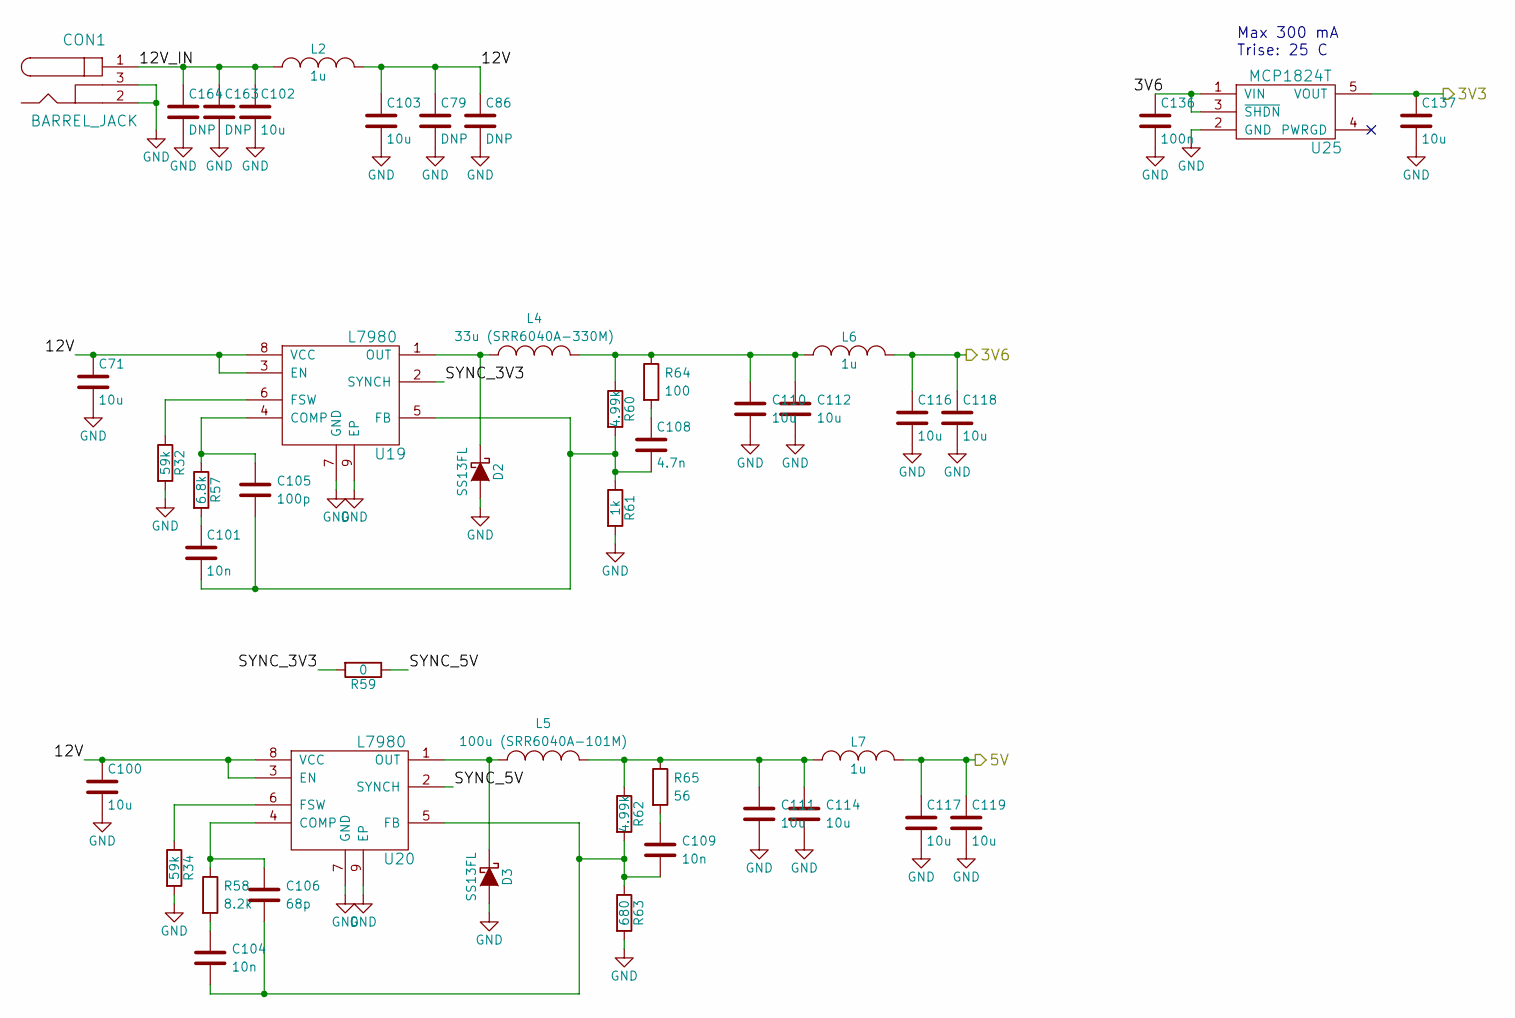
[picture p14: schematic power.sch, VNA]

Parts:
C71, C100, C102, C103, C110, C111, C112, C114, C116, C117, C118, C119, C137: 10u; C_0805b
C79, C86, C163, C164: DNP; C_0805b
C101, C104, C109: 10n; C_0402b
C105: 100p; C_0402b
C106: 68p; C_0402b
C108: 4.7n; C_0402b
C136: 100n; C_0402b
CON1: BARREL_JACK; EJ508A
D2, D3: SS13FL; SOD-123F
L2, L6, L7: 1u; C_0805b
L4: 33u (SRR6040A-330M); SRR6040A
L5: 100u (SRR6040A-101M); SRR6040A
R32, R34: 59k; R_0402b
R57: 6.8k; R_0402b
R58: 8.2k; R_0402b
R59: 0; R_0402b
R60, R62: 4.99k; R_0402b
R61: 1k; R_0402b
R63: 680; R_0402b
R64: 100; R_0402b
R65: 56; R_0402b
U19, U20: L7980; DFN-8-1EP_3x3mm_Pitch0.5mm
U25: MCP1824T; SOT-23-5

Connections:
/microcontroller/3V3: C137.1, U25.5 (VOUT); also elsewhere on the board
/power/3V6: C116.1, C118.1, C136.1, L6.2, U25.1 (VIN), U25.3 (~SHDN); also elsewhere on the board
/power/5V: C117.1, C119.1, L7.2; also elsewhere on the board
/power/12V: C71.1, C79.1, C86.1, C100.1, C103.1, L2.2, U19.3 (EN), U19.8 (VCC), U20.3 (EN), U20.8 (VCC)
/power/12V_IN: C102.1, C163.1, C164.1, CON1.1, L2.1
/power/SYNC_3V3: R59.2, U19.2 (SYNCH)
/power/SYNC_5V: R59.1, U20.2 (SYNCH)
GND: C71.2, C79.2, C86.2, C100.2, C102.2, C103.2, C110.2, C111.2, C112.2, C114.2, C116.2, C117.2, C118.2, C119.2, C136.2, C137.2, C163.2, C164.2, CON1.2, CON1.3, D2.2 (A), D3.2 (A), R32.2, R34.2, R61.2, R63.2, U19.7 (GND), U19.9 (EP), U20.7 (GND), U20.9 (EP), U25.2 (GND); also elsewhere on the board
unnamed: C101.1, R57.2
unnamed: C101.2, C105.2, C108.2, R60.2, R61.1, U19.5 (FB)
unnamed: C104.1, R58.2
unnamed: C104.2, C106.2, C109.2, R62.2, R63.1, U20.5 (FB)
unnamed: C105.1, R57.1, U19.4 (COMP)
unnamed: C106.1, R58.1, U20.4 (COMP)
unnamed: C108.1, R64.2
unnamed: C109.1, R65.2
unnamed: C110.1, C112.1, L4.2, L6.1, R60.1, R64.1
unnamed: C111.1, C114.1, L5.2, L7.1, R62.1, R65.1
unnamed: D2.1 (K), L4.1, U19.1 (OUT)
unnamed: D3.1 (K), L5.1, U20.1 (OUT)
unnamed: R32.1, U19.6 (FSW)
unnamed: R34.1, U20.6 (FSW)

Notes on the sheet:
Max 300 mA Trise: 25 C

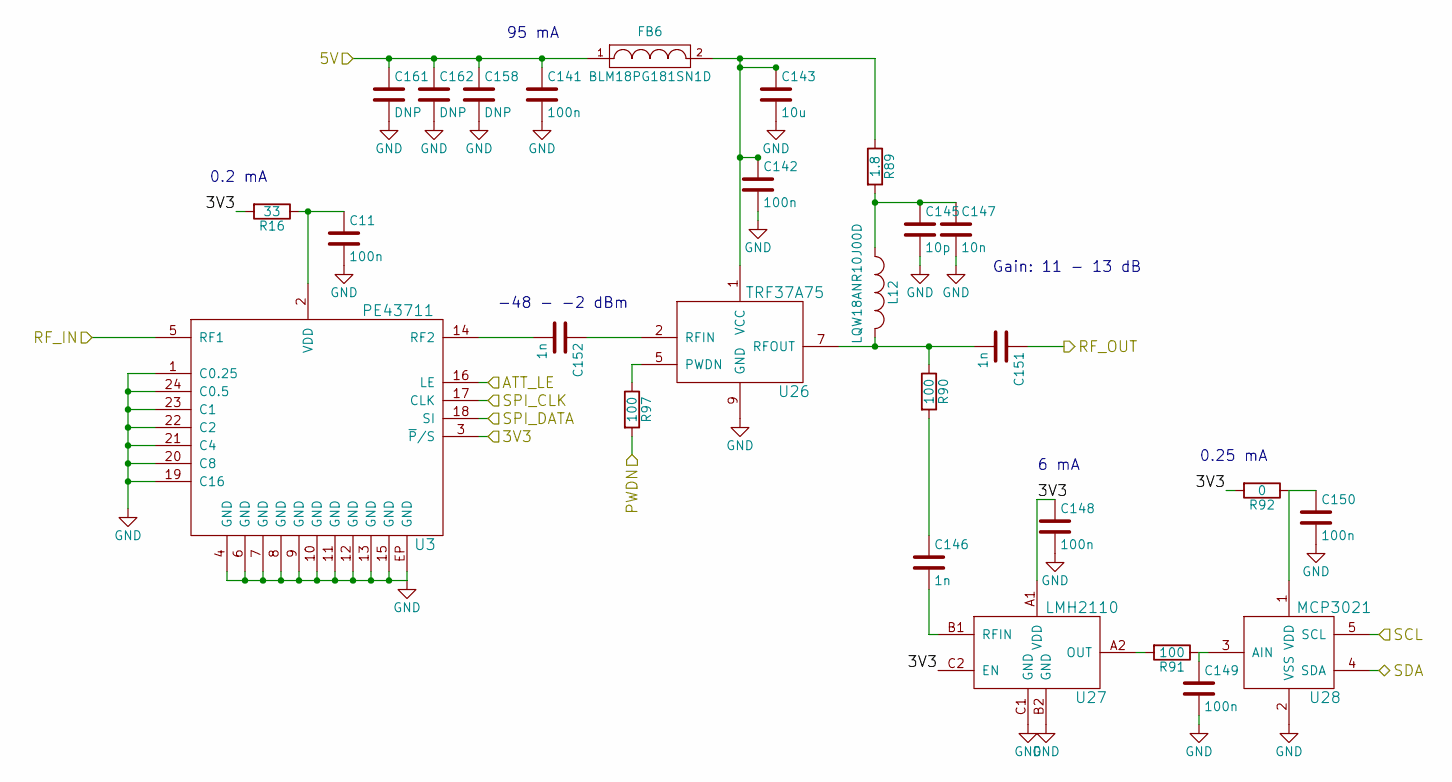
[picture p15: schematic tx_amp.sch, VNA]

Parts:
C11, C141, C142, C148, C149, C150: 100n; C_0402b
C143: 10u; C_0805b
C145: 10p; C_0402b
C146, C151, C152: 1n; C_0402b
C147: 10n; C_0402b
C158: DNP; C_0805b
C161, C162: DNP; C_0402b
FB6: BLM18PG181SN1D; C_0603b
L12: LQW18ANR10J00D; C_0603b
R16: 33; R_0402b
R89: 1.8; R_0603b
R90, R91, R97: 100; R_0402b
R92: 0; R_0402b
U3: PE43711; VQFN-24
U26: TRF37A75; DFN-8-1EP_2x2mm_Pitch0.5mm
U27: LMH2110; WFBGA-6
U28: MCP3021; SOT-23-5

Connections:
/microcontroller/3V3: C148.1, R16.2, R92.2, U3.3 (~P~/S), U27.A1 (VDD), U27.C2 (EN); also elsewhere on the board
/microcontroller/ATT_LE: U3.16 (LE); also elsewhere on the board
/microcontroller/I2C_SCL: U28.5 (SCL); also elsewhere on the board
/microcontroller/I2C_SDA: U28.4 (SDA); also elsewhere on the board
/microcontroller/PWDN: R97.2; also elsewhere on the board
/power/5V: C141.1, C158.1, C161.1, C162.1, FB6.1; also elsewhere on the board
/receiver/CLK: U3.17 (CLK); also elsewhere on the board
/receiver/DATA: U3.18 (SI); also elsewhere on the board
/tx_amp/RF_IN: U3.5 (RF1); also elsewhere on the board
/tx_amp/RF_OUT: C151.1; also elsewhere on the board
GND: C11.2, C141.2, C142.2, C143.2, C145.2, C147.2, C148.2, C149.2, C150.2, C158.2, C161.2, C162.2, U3.1 (C0.25), U3.4 (GND), U3.6 (GND), U3.7 (GND), U3.8 (GND), U3.9 (GND), U3.10 (GND), U3.11 (GND), U3.12 (GND), U3.13 (GND), U3.15 (GND), U3.19 (C16), U3.20 (C8), U3.21 (C4), U3.22 (C2), U3.23 (C1), U3.24 (C0.5), U3.EP (GND), U26.9 (GND), U27.B2 (GND), U27.C1 (GND), U28.2 (VSS); also elsewhere on the board
unnamed: C11.1, R16.1, U3.2 (VDD)
unnamed: C142.1, C143.1, FB6.2, R89.1, U26.1 (VCC)
unnamed: C145.1, C147.1, L12.1, R89.2
unnamed: C146.1, R90.2
unnamed: C146.2, U27.B1 (RFIN)
unnamed: C149.1, R91.1, U28.3 (AIN)
unnamed: C150.1, R92.1, U28.1 (VDD)
unnamed: C151.2, L12.2, R90.1, U26.7 (RFOUT)
unnamed: C152.1, U26.2 (RFIN)
unnamed: C152.2, U3.14 (RF2)
unnamed: R91.2, U27.A2 (OUT)
unnamed: R97.1, U26.5 (PWDN)

Notes on the sheet:
-48 - -2 dBm
Gain: 11 - 13 dB
6 mA
0.25 mA
95 mA
0.2 mA

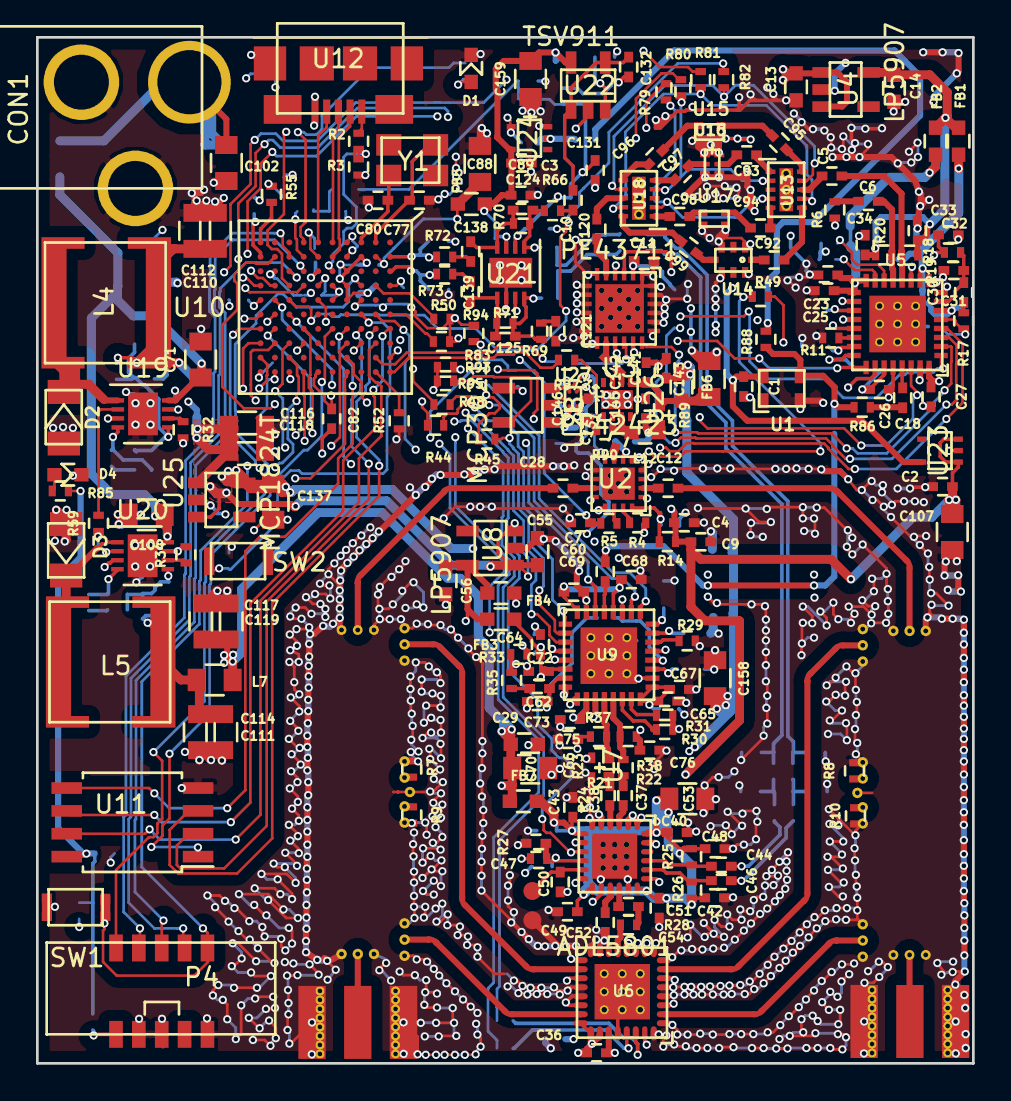
[picture p16: board vna.kicad_pcb from above]

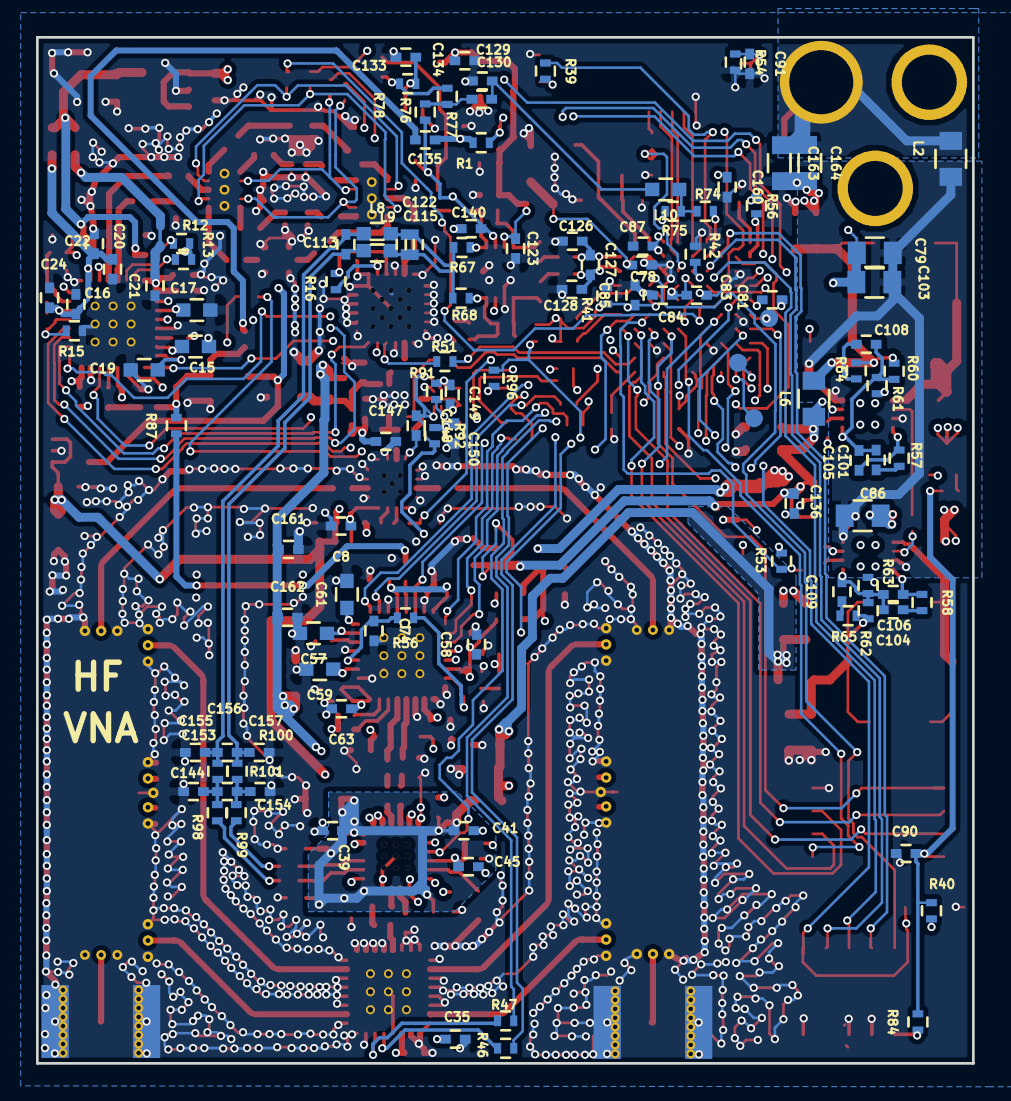
[picture p17: board vna.kicad_pcb from below]

Board: 4 copper layers, 52.0 x 57.0 mm, 342 parts (113 on the bottom side), 237 nets.
