Ttl/vna/firmware/hackrf_usb/hackrf_usb.c

/*
 * Copyright 2012 Jared Boone
 * Copyright 2013 Benjamin Vernoux
 *
 * This file is part of HackRF.
 *
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
 * You should have received a copy of the GNU General Public License
 * along with this program; see the file COPYING.  If not, write to
 * the Free Software Foundation, Inc., 51 Franklin Street,
 * Boston, MA 02110-1301, USA.
 */

#include <stdint.h>
#include <stddef.h>
#include "signal_mcu.h"
#include "m0_bin.h"

#include <libopencm3/cm3/vector.h>

#include <libopencm3/lpc43xx/ipc.h>
#include <libopencm3/lpc43xx/scu.h>
#include <libopencm3/lpc43xx/ccu.h>
#include <libopencm3/lpc43xx/gpio.h>
#include <libopencm3/lpc43xx/m4/nvic.h>

#include <streaming.h>

#include "usb.h"
#include "usb_standard_request.h"

#include <rom_iap.h>
#include "usb_descriptor.h"

#include "usb_device.h"
#include "usb_endpoint.h"
#include "usb_api_board_info.h"
#include "usb_api_register.h"
#include "usb_api_spiflash.h"

#include "usb_api_transceiver.h"
#include "rf_path.h"
#include "sgpio_isr.h"
#include "usb_bulk_buffer.h"
#include "sgpio.h"
#include "adchs.h"

#define USB_DATA_TRANSFER_SIZE_BYTE (ADCHS_DATA_TRANSFER_SIZE_BYTE)
#define USB_BULK_BUFFER_MASK ((32768) - 1)
#define get_usb_buffer_offset() (usb_bulk_buffer_offset)
#define set_usb_buffer_offset(val) (usb_bulk_buffer_offset = val)
/* Manage round robin after increment with USB_BULK_BUFFER_MASK */
#define inc_mask_usb_buffer_offset(buff_offset, inc_value) ((buff_offset+inc_value) & USB_BULK_BUFFER_MASK)


#define SLAVE_TXEV_FLAG ((uint32_t *) 0x40043400)
#define SLAVE_TXEV_QUIT() { *SLAVE_TXEV_FLAG = 0x0; }

static volatile transceiver_mode_t _transceiver_mode = TRANSCEIVER_MODE_OFF;

static volatile int new_transfer = 0;

const int use_packing = 0;

void set_transceiver_mode(const transceiver_mode_t new_transceiver_mode) {
	usb_endpoint_disable(&usb_endpoint_bulk_in);
	usb_endpoint_disable(&usb_endpoint_bulk_out);

	_transceiver_mode = new_transceiver_mode;

	if( _transceiver_mode == TRANSCEIVER_MODE_RX ) {
        usb_endpoint_init(&usb_endpoint_bulk_in);
        usb_bulk_buffer_offset = 0;
	} else if (_transceiver_mode == TRANSCEIVER_MODE_TX) {
		//usb_endpoint_init(&usb_endpoint_bulk_out);
	}
}

transceiver_mode_t transceiver_mode(void) {
	return _transceiver_mode;
}

usb_request_status_t usb_vendor_request_set_transceiver_mode(
	usb_endpoint_t* const endpoint,
	const usb_transfer_stage_t stage
) {
	if( stage == USB_TRANSFER_STAGE_SETUP ) {
		switch( endpoint->setup.value ) {
		case TRANSCEIVER_MODE_OFF:
		case TRANSCEIVER_MODE_RX:
		case TRANSCEIVER_MODE_TX:
			set_transceiver_mode(endpoint->setup.value);
			usb_transfer_schedule_ack(endpoint->in);
			return USB_REQUEST_STATUS_OK;
		default:
			return USB_REQUEST_STATUS_STALL;
		}
	} else {
		return USB_REQUEST_STATUS_OK;
	}
}

static const usb_request_handler_fn vendor_request_handler[] = {
	NULL, //0
	usb_vendor_request_set_transceiver_mode, //1
    usb_vendor_request_write_lo, //2
    usb_vendor_request_write_source, //3
    usb_vendor_request_set_gpio, //4
    usb_vendor_request_clear_gpio, //5
    usb_vendor_request_set_filter, //6
    usb_vendor_request_set_rx_ch, //7
    usb_vendor_request_set_tx_port, //8
    usb_vendor_request_write_att, //9
	usb_vendor_request_erase_spiflash, //10
	usb_vendor_request_write_spiflash, //11
	usb_vendor_request_read_spiflash, //12
	NULL,
	usb_vendor_request_read_board_id, //14
	usb_vendor_request_read_version_string, //15
    NULL,
    NULL,
	usb_vendor_request_read_partid_serialno, //18
    usb_vendor_request_read_mcp3021, //19
    usb_vendor_request_sample, //20
    NULL,
	NULL,
	NULL,
    NULL,
};

static const uint32_t vendor_request_handler_count =
	sizeof(vendor_request_handler) / sizeof(vendor_request_handler[0]);

usb_request_status_t usb_vendor_request(
	usb_endpoint_t* const endpoint,
	const usb_transfer_stage_t stage
) {
	usb_request_status_t status = USB_REQUEST_STATUS_STALL;

	if( endpoint->setup.request < vendor_request_handler_count ) {
		usb_request_handler_fn handler = vendor_request_handler[endpoint->setup.request];
		if( handler ) {
			status = handler(endpoint, stage);
		}
	}

	return status;
}

const usb_request_handlers_t usb_request_handlers = {
	.standard = usb_standard_request,
	.class = 0,
	.vendor = usb_vendor_request,
	.reserved = 0,
};

void usb_configuration_changed(
	usb_device_t* const device
) {
	/* Reset transceiver to idle state until other commands are received */
	set_transceiver_mode(TRANSCEIVER_MODE_OFF);
	if( device->configuration->number == 1 ) {
		// transceiver configuration
		cpu_clock_pll1_max_speed();
	} else {
		/* Configuration number equal 0 means usb bus reset. */
		cpu_clock_pll1_low_speed();
		//gpio_clear(PORT_LED1_3, PIN_LED1);
	}
}

void usb_set_descriptor_by_serial_number(void)
{
	iap_cmd_res_t iap_cmd_res;

	/* Read IAP Serial Number Identification */
	iap_cmd_res.cmd_param.command_code = IAP_CMD_READ_SERIAL_NO;
	iap_cmd_call(&iap_cmd_res);

	if (iap_cmd_res.status_res.status_ret == CMD_SUCCESS) {
		usb_descriptor_string_serial_number[0] = USB_DESCRIPTOR_STRING_SERIAL_BUF_LEN;
		usb_descriptor_string_serial_number[1] = USB_DESCRIPTOR_TYPE_STRING;

		/* 32 characters of serial number, convert to UTF-16LE */
		for (size_t i=0; i<USB_DESCRIPTOR_STRING_SERIAL_LEN; i++) {
			const uint_fast8_t nibble = (iap_cmd_res.status_res.iap_result[i >> 3] >> (28 - (i & 7) * 4)) & 0xf;
			const char c = (nibble > 9) ? ('a' + nibble - 10) : ('0' + nibble);
			usb_descriptor_string_serial_number[2 + i * 2] = c;
			usb_descriptor_string_serial_number[3 + i * 2] = 0x00;
		}
	} else {
		usb_descriptor_string_serial_number[0] = 2;
		usb_descriptor_string_serial_number[1] = USB_DESCRIPTOR_TYPE_STRING;
	}
}

void adchs_start(uint8_t chan_num)
{
  int i;
  uint32_t *dst;

  /* Disable IRQ globally */
  __asm__("cpsid i");


  /* Clear ADCHS Buffer */
  dst = (uint32_t *)ADCHS_DATA_BUFFER;
  for(i=0; i<(ADCHS_DATA_BUFFER_SIZE_BYTE/4); i++)
  {
    dst[i] = 0;
  }
  usb_bulk_buffer_offset = 0;

  ADCHS_init();
  ADCHS_desc_init(chan_num);
  ADCHS_DMA_init((uint32_t)ADCHS_DATA_BUFFER, use_packing);

  LPC_ADCHS->TRIGGER = 1;
  __asm("dsb");

  /* Enable IRQ globally */
  __asm__("cpsie i");
}

void adchs_stop(void)
{
  /* Disable IRQ globally */
  __asm__("cpsid i");

  ADCHS_deinit();

  /* Enable IRQ globally */
  __asm__("cpsie i");
}

void dma_isr(void)
{
  uint32_t status;
  #define INTTC0  (1)
  //gpio_set(PORT_LED1_3, PIN_LED1);

  status = LPC_GPDMA->INTTCSTAT;
  if( status & INTTC0 && new_transfer == 0 )
  {
    set_transceiver_mode(TRANSCEIVER_MODE_RX);
    LPC_GPDMA->INTTCCLEAR |= INTTC0; /* Clear Chan0 */
    if(use_packing)
    {
        set_usb_buffer_offset( inc_mask_usb_buffer_offset(get_usb_buffer_offset(), 8192));
    }
    else
    {
        set_usb_buffer_offset( inc_mask_usb_buffer_offset(get_usb_buffer_offset(), USB_DATA_TRANSFER_SIZE_BYTE) );
    }
    new_transfer = 1;
  }

  //gpio_clear(PORT_LED1_3, PIN_LED1);
}

int main(void) {
	pin_setup();
	cpu_clock_init();

    ipc_halt_m0();
    ipc_halt_m0s();

    // Disable M0 Sub
    CCU1_CLK_PERIPH_CORE_CFG &= ~(1);

	usb_set_descriptor_by_serial_number();

	usb_set_configuration_changed_cb(usb_configuration_changed);

	usb_peripheral_reset();

	usb_device_init(0, &usb_device);

	usb_queue_init(&usb_endpoint_control_out_queue);
	usb_queue_init(&usb_endpoint_control_in_queue);
    usb_queue_init(&usb_endpoint_bulk_out_queue);
	usb_queue_init(&usb_endpoint_bulk_in_queue);

	usb_endpoint_init(&usb_endpoint_control_out);
	usb_endpoint_init(&usb_endpoint_control_in);
    usb_endpoint_init(&usb_endpoint_bulk_in);

	nvic_set_priority(NVIC_USB0_IRQ, 255);
    nvic_set_priority(NVIC_DMA_IRQ, 1);
    nvic_set_priority(NVIC_RITIMER_IRQ, 128);


    nvic_enable_irq(NVIC_DMA_IRQ);
    nvic_enable_irq(NVIC_RITIMER_IRQ);

	usb_run(&usb_device);
	ssp1_init();

    adchs_start(0);

    //SGPIO is used to make ADC dithering signal
    sgpio_configure();

	while(true) {

        /*
        if (gpio_get(PORT_LO_LD, PIN_LO_LD )) {
            gpio_set(PORT_LED1_3, PIN_LED1);
        } else {
            gpio_clear(PORT_LED1_3, PIN_LED1);
        }
        */

        if(new_transfer)
        {
          usb_transfer_schedule_block(&usb_endpoint_bulk_in, &usb_bulk_buffer[0], 0x4000, NULL, NULL);
          usb_transfer_schedule_block(&usb_endpoint_bulk_in, &usb_bulk_buffer[0x4000], 0x4000, NULL, NULL);
          new_transfer = 0;
        }

	}
	return 0;
}
