Ttl/vna/firmware/common/adchs.c

/*
 * Copyright 2013-2016 Benjamin Vernoux <bvernoux@airspy.com>
 * Copyright 2015 Ian Gilmour <ian@sdrsharp.com>
 *
 * This file is part of AirSpy.
 *
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
 * You should have received a copy of the GNU General Public License
 * along with this program; see the file COPYING.  If not, write to
 * the Free Software Foundation, Inc., 51 Franklin Street,
 * Boston, MA 02110-1301, USA.
 */

#include <hackrf_core.h>
#include <libopencm3/lpc43xx/creg.h>
#include <libopencm3/lpc43xx/rgu.h>
#include "adchs.h"

#define RESET_CTRL1_ADCHS_SHIFT (28)
#define RESET_CTRL1_ADCHS (1 << RESET_CTRL1_ADCHS_SHIFT)
#define STATUS0_CLEAR (0x7D)
#define STATUS0_CLEAR_MASK (0x7F)
#define STATUS1_CLEAR_MASK (0x1FFFFFFF)

typedef struct
{
  uint32_t src_addr;
  uint32_t dst_addr;
  uint32_t next_lli;
  uint32_t control;
} t_gpdma_lli;

typedef struct
{
  uint8_t data[ADCHS_DMA_NB_BUFFER][ADCHS_DATA_TRANSFER_SIZE_BYTE];
} t_adchs_buffer;

t_adchs_buffer* adchs_data_buffer_filled = (t_adchs_buffer*)ADCHS_DATA_BUFFER;

/* Allocate aligned buffer on 16bytes for DMA LLI */
t_gpdma_lli adchs_dma_lli[ADCHS_DMA_NUM_LLI] __attribute__ ((aligned(16)));

void ADCHS_DMA_init_stop(void)
{
  /* clear all interrupts on channel 0 */
  LPC_GPDMA->INTTCCLEAR = 0x01;
  LPC_GPDMA->INTERRCLR = 0x01;

  /* Setup the DMAMUX */
  CREG_DMAMUX &= ~(0x3<<(ADCHS_DMA_WRITE*2));
  CREG_DMAMUX |= 0x3<<(ADCHS_DMA_WRITE*2);
  CREG_DMAMUX &= ~(0x3<<(ADCHS_DMA_READ*2));
  CREG_DMAMUX |= 0x3<<(ADCHS_DMA_READ*2);

  LPC_GPDMA->CONFIG = 0x01; /* Enable DMA channels, little endian */
  while ( !(LPC_GPDMA->CONFIG & 0x01) );

  /* Disable Channel before to change settings */
  LPC_GPDMA->CONFIG = 0x00; /* Disable DMA channels, little endian */
}

void ADCHS_restart_dma(void) {

  //Disable DMA while configuring it
  LPC_GPDMA->C0CONFIG =  (0x0)        |          // Enable bit
                     (ADCHS_DMA_READ << 1) |
                     (0x0 << 6)   |
                     (0x2 << 11)  |
                     (0x1 << 14)  |
                     (0x1 << 15);

  LPC_GPDMA->CONFIG = 0x00;

  LPC_GPDMA->C0SRCADDR = adchs_dma_lli[0].src_addr;
  LPC_GPDMA->C0DESTADDR = adchs_dma_lli[0].dst_addr;
  LPC_GPDMA->C0CONTROL = adchs_dma_lli[0].control;
  LPC_GPDMA->C0LLI     = (uint32_t)(&adchs_dma_lli[1]); // must be pointing to the second LLI as the first is used when initializing
  LPC_GPDMA->C0CONFIG =  (0x1)        |          // Enable bit
                         (ADCHS_DMA_READ << 1) |
                         (0x0 << 6)   |
                         (0x2 << 11)  |
                         (0x1 << 14)  |
                         (0x1 << 15);
  //Flushes old samples from FIFO
  LPC_ADCHS->FLUSH = 1;
  LPC_GPDMA->CONFIG = 0x01;
}

void ADCHS_DMA_init(uint32_t dest_addr, uint8_t packed)
{
  uint32_t nb_dma_transfer;
  int i;

  ADCHS_DMA_init_stop();

  /* Configure DMA LLI in Round Rubin */
  // The size of the transfer is in multiples of 32bit copies (hence the /4)
  // and must be even multiples of ADC_FIFO_LEVEL.
  nb_dma_transfer = ADCHS_DATA_BUFFER_SIZE_BYTE / (ADC_FIFO_LEVEL * ADCHS_DMA_NUM_LLI);
  nb_dma_transfer = (nb_dma_transfer * ADC_FIFO_LEVEL) / 4;

  for(i=0; i<ADCHS_DMA_NUM_LLI; i++)
  {
    adchs_dma_lli[i].src_addr = ADCHS_DMA_READ_SRC;
    adchs_dma_lli[i].dst_addr = ((uint32_t)dest_addr) + (nb_dma_transfer*4*i);
    /* Modulo with round rubin last LLI point to First in infinite loop */
    adchs_dma_lli[i].next_lli = (uint32_t)(&adchs_dma_lli[(i+1)%ADCHS_DMA_NUM_LLI]);

    adchs_dma_lli[i].control = ( (nb_dma_transfer) << 0) |
                               (0x2 << 12)  |
                               (0x2 << 15)  |
                               (0x2 << 18)  |
                               (0x2 << 21)  |
                               (0x1 << 24)  |
                               (0x1 << 25)  |
                               (0x0 << 26)  |
                               (0x1 << 27)  |
                               (0x0UL << 31);
  }

  adchs_dma_lli[i-1].next_lli = 0;
  if(packed)
  {
    for(i=0; i<ADCHS_DMA_NUM_LLI; i++)
    {
      adchs_dma_lli[i].control |= (0x1UL << 31);
    }
  }
  else
  {
    //Raise interrupt when half have been transferred
    //This assumes we can fill the rest faster than first part
    //can be sent to the computer
    adchs_dma_lli[(ADCHS_DMA_NUM_LLI/2)-1].control |= (0x1UL << 31);
  }

  LPC_GPDMA->C0SRCADDR = adchs_dma_lli[0].src_addr;
  LPC_GPDMA->C0DESTADDR = adchs_dma_lli[0].dst_addr;
  LPC_GPDMA->C0CONTROL = adchs_dma_lli[0].control;
  LPC_GPDMA->C0LLI     = (uint32_t)(&adchs_dma_lli[1]); // must be pointing to the second LLI as the first is used when initializing
  LPC_GPDMA->C0CONFIG =  (0x1)        |          // Enable bit
                         (ADCHS_DMA_READ << 1) |
                         (0x0 << 6)   |
                         (0x2 << 11)  |
                         (0x1 << 14)  |
                         (0x1 << 15);

  LPC_GPDMA->CONFIG = 0x01; /* Enable DMA channels, little endian */
}

void ADCHS_init_stop(void)
{
  /* Reset ADCHS using RGU */
  RESET_CTRL1 = RESET_CTRL1_ADCHS;
  /* Wait end of Reset */
  while( (RESET_ACTIVE_STATUS1 & RESET_CTRL1_ADCHS) != RESET_CTRL1_ADCHS );

  LPC_ADCHS->CLR_EN0 = STATUS0_CLEAR_MASK;
  LPC_ADCHS->CLR_STAT0 = STATUS0_CLEAR_MASK;

  while(LPC_ADCHS->STATUS0 & STATUS0_CLEAR);

  LPC_ADCHS->CLR_EN1 = STATUS1_CLEAR_MASK;
  LPC_ADCHS->CLR_STAT1 = STATUS1_CLEAR_MASK;
  while(LPC_ADCHS->STATUS1);

  LPC_ADCHS->POWER_DOWN = (0<<0);
  LPC_ADCHS->FLUSH = 1;
  LPC_ADCHS->FIFO_CFG = ADC_FIFO_LEVEL<<1 | 0x1;
}

void ADCHS_deinit(void)
{
  ADCHS_DMA_init_stop();
  ADCHS_init_stop();
  LPC_ADCHS->POWER_CONTROL = 0x0;
}

/* Initialized ADCHS for freq between 0 to less than 30MSPS */
void ADCHS_init(void)
{
  uint32_t i;

  ADCHS_init_stop();

  LPC_ADCHS->CONFIG =
  ( 0x1 << 0 ) | //Software trigger
  ( 0x0 << 2 ) |
  ( 0x0  << 4 ) |
  ( 0x0  << 5 ) |
  ( 0x90 << 6 );

  /* Configure and Enable ADCHS for fADC less than 20MS/s */
  LPC_ADCHS->POWER_CONTROL =
  0 |
  (0x1 << 4)   | //Internal DC-bias on - pin
  (0x1 << 10)  | //Internal DC-bias on + pin
  (0 << 16)    | //Offset binary output
  (1 << 17)    | //ADC active
  (1 << 18);     // Bandgap reference active
  LPC_ADCHS->ADC_SPEED = 0x0;

  LPC_ADCHS->FLUSH = 1;

  for(i = 0; i < 5; i++ )
  {
    while( LPC_ADCHS->FIFO_STS ); /* Wait until FIFO empty. */
  }

  /* Configure Threshold A & B to default value (even if not used) */
  LPC_ADCHS->THR_A = 0x00FFF000;
  LPC_ADCHS->THR_B = 0x00FFF000;

  /* Configure Interrupt 0 & 1 Enable register to default value (even if not used) */
  LPC_ADCHS->CLR_EN0   = STATUS0_CLEAR_MASK;
  LPC_ADCHS->CLR_STAT0 = STATUS0_CLEAR_MASK;
  LPC_ADCHS->CLR_EN1   = STATUS1_CLEAR_MASK;
  LPC_ADCHS->CLR_STAT1 = STATUS1_CLEAR_MASK;

}

void ADCHS_desc_init(uint8_t chan_num)
{
  LPC_ADCHS->DSCR_STS =
    (1<<0) | //Active table 1
    (0<<1); //Descriptor 0 active

  LPC_ADCHS->DESCRIPTOR_1[0] =
  (chan_num << 0) | //Channel to sample
  (0 << 3)        | //Do not halt after done
  (0 << 4)        | //No interrupt when done
  (0 << 5)        | //Do not power done when done
  (0x2 << 6)      | //Swap tables when done
  (1 << 8)        | //Timer match value
  (0 << 22)       | //Threshold set
  (1 << 24)       | //Reset timer
  (0x1U << 31); //Update table

  LPC_ADCHS->DESCRIPTOR_0[0] =
  (chan_num << 0) |
  (0 << 3)        |
  (0 << 4)        |
  (0 << 5)        |
  (0x1 << 6)      |
  (0 << 8)        |
  (0 << 22)       |
  (1 << 24)       |
  (0x1U << 31);

}
