Ttl/vna/software/lmh2110_cal_table.py

cal_table = {0: ((9.908319448927678, 14.060475241299143, 17.864875748520518, 22.284351492703053, 30.47894989627986, 41.68693834703355, 56.493697481230285, 75.1622894018206, 109.64781961431862, 161.4358556826487, 218.7761623949554, 304.78949896279863, 401.79081084894045, 524.8074602497734, 666.8067692136233, 824.138115013003, 928.9663867799372, 1116.8632477805625, 1367.7288255958508, 1644.371723214934, 2051.162178825569, 2421.0290467361824, 2679.1683248190343, 2992.264636608195, 3341.950400261146, 3837.072454922792, 4528.975799036219, 4875.2849010338705, 5199.959965335168, 5701.642722807484, 6025.595860743593, 6367.9552090791685, 6729.766562843189, 7244.359600749914, 8165.823713585939, 8472.274141405971, 10375.284158180148), (1.4167847314691522, 1.53102885042166, 1.5841065246338215, 1.6212197070572572, 1.660924988903684, 1.6766622281402574, 1.6817541056369285, 1.6868601864181092, 1.6839059032401242, 1.6809445184198846, 1.6727208166888594, 1.6618126941855305, 1.6509471815357302, 1.634762538837106, 1.6212623169107858, 1.5971309365290725, 1.5783968042609855, 1.5702654238792721, 1.5541304926764314, 1.5300204172214826, 1.503218819351975, 1.471133599644918, 1.4337718597425657, 1.3884136706613406, 1.3430554815801155, 1.3003391034176655, 1.246948956946294, 1.1803142476697737, 1.1163497558810476, 1.0443746116289394, 0.9857434531735465, 0.9271122947181536, 0.8711442521083004, 0.8284775854416335, 0.8283852640923215, 0.7777576564580562, 0.41009143364403045)), -25: ((9.908319448927678, 11.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
