Ttl/vna/(commit log)

2016-06-19 Add source power detector readout
2016-07-27 Add hardware design files
    [filter_bank.sch, microcontroller.sch, power.sch, receiver.sch, transmitter.sch, tx_amp.sch, vna.kicad_pcb, vna.sch]
2016-08-02 Add pdf of schematic
2016-08-10 Wait for PLLs to lock, better DMA setup
    Cleaning
2016-08-11 Fix 1-port channel sampling lengths
    Lengths changed when the firmware was changed.
    [vna.py]
2016-08-13 Add ADC dithering
    Replaced delay loop in sampling with timer
    [hackrf_core.c, hackrf_usb.c, rf_path.c, sgpio.c, sgpio.h]
2016-08-14 Configurable channel sampling
    Channels to be sampled and their sampling times
    can now be configured with PC.
2016-08-15 Automatically determine channel boundaries in sampled data
2016-08-18 Frequency offset estimation with Kalman filter
    Estimates the on-board oscillator frequency offset from RX channel
    measurement.
    Currently very slow and probably not necessary to do at every frequency point
    Also averaged IQ sample is now calculated right after the measurement
    by normalizing phase of the RX channel to 0.
    [vna.py]
2016-12-10 Bug fixes
    Fix missing and wrong sized PLL register definitions.
    Fix the digital LO frequency and remove the unneeded frequency
    offset estimation.
    [vna.py]
2017-08-17 Add power calibration file
