Ttl/vna/(notices)

Notices in the files:
firmware/libopencm3/include/libopencm3/lpc43xx/i2c.h:
This library is free software: you can redistribute it and/or modify
it under the terms of the GNU Lesser General Public License as published by
the Free Software Foundation, either version 3 of the License, or
(at your option) any later version.
firmware/common/sgpio.c:
This program is free software; you can redistribute it and/or modify
it under the terms of the GNU General Public License as published by
the Free Software Foundation; either version 2, or (at your option)
